qianshuyuank/MLKPAI-FMin01/02_hardware/03_开发板等长说明/MLKPAI-FMin01开发板等长说明.txt

HDMI 共8根GPIO/4对差分对，做pin pair全部等长；误差正负0.127MM；Len=38.4718MM

DVP    共20根GPIO/10对差分对，做pin pair全部等长；误差正负0.127MM；Len=20.1094MM

TF       共6根GPIO，做pin pair全部等长；误差正负0.127MM；Len=14.6431MM
