qianshuyuank/MLKPAI-FMin01/02_hardware/07_Pinlist/DVP接口引脚定义表.xlsx

DVP
信号名 |  | 管脚号
1 | VCC_3V3 | \
2 | VCC_3V3 | \
3 | B4_BE2N_40 | 40
4 | B4_BE2P_41 | 41
5 | B4_BE1P_37 | 37
6 | B4_BE1N_38 | 38
7 | GND | \
8 | \ | \
9 | \ | \
10 | GND | \
11 | \ | \
12 | \ | \
13 | B3_BE2N_33 | 33
14 | B3_BE2P_32 | 32
15 | GND | \
16 | \ | \
17 | \ | \
18 | B3_BE1N_28 | 28
19 | B3_BE1P_29 | 29
20 | GND | \
21 | B1_L2P_10 | 10
22 | B1_L2N_11 | 11
23 | B1_L3P_12 | 12
24 | B1_L3N_13 | 13
25 | GND | \
26 | B8_TE1N_87 | 87
27 | B8_TE1P_86 | 86
28 | B7_TE1P_70 | 70
29 | B7_TE1N_71 | 71
30 | GND | \
31 | \ | \
32 | \ | \
33 | B6_R2P_64 | 64
34 | B6_R2N_63 | 63
35 | \ | \
36 | \ | \
37 | B1_L1P_5 | 5
38 | B1_L1N_4 | 4
39 | \ | \
40 | \ | \
