qianshuyuank/MLKPAI-FMin01/02_hardware/07_Pinlist/LED、拨码开关、按键与蜂鸣器引脚定义表.xlsx

LED
信号名 | 管脚
B1_L4_14 | 14
B1_L2_3 | 3
B1_L1_2 | 2
B5_R2_51 | 51
B5_R3_52 | 52
B6_R1_57 | 57
B6_R2_59 | 59
B6_R3_62 | 62
按键
信号名 | 管脚
B3_B6_31 | 31
B3_B5_30 | 30
BUZZER
信号名 | 管脚
B3_B4_27 | 27
拨码开关
信号名 | 管脚
B5_R1_45 | 45
B3_B1_23 | 23
B2_L2_19 | 19
B2_L1_18 | 18
