qianshuyuank/MLKPAI-FMin01/02_hardware/07_Pinlist/FLASH管脚定义表.xlsx

信号名 | 引脚号 | FPGA管脚
AS_rCSO | /CS | 69
AS_DATA | DO | 80
AS_DCLK | CLK | 82
AS_ASDO | DI | 81
