qianshuyuank/MLKPAI-FMin01/02_hardware/07_Pinlist/HDMI引脚定义表.xlsx

HDMI
信号名 | 管脚号
B6_R1P_61 | 61
B6_R1N_60 | 60
B5_R2P_49 | 49
B5_R2N_50 | 50
B5_R1P_47 | 47
B5_R1N_48 | 48
B5_R3P_55 | 55
B5_R3N_54 | 54
