qianshuyuank/MLKPAI-FMin01/02_hardware/07_Pinlist/JTAG管脚定义表 .xlsx

信号名 | FPGA管脚
JTAG_TMS | 22
JTAG_TCK | 26
JTAG_TDO | 21
JTAG_TDI | 25
