qianshuyuank/MLKPAI-FMin01/02_hardware/07_Pinlist/TF卡槽、EEPROM与RTC引脚定义表.xlsx

TF
信号名 | 管脚号
B7_T5_74 | 74
B7_T6_75 | 75
B7_T7_76 | 76
B7_T2P_78 | 78
B7_TE2N_77 | 77
B7_T8_79 | 79
EEPROM/RTC
信号名 | 管脚号
B4_B2_39 | 39
B4_B3_42 | 42
