qianshuyuank/MLKPAI-FMin01/02_hardware/07_Pinlist/UART引脚信号定义表.xlsx

信号名 | 管脚
FPGA_UART_TXD | 17
FPGA_UART_RXD | 16
