qianshuyuank/MLKPAI-FMin01/01_start/02_peripheral_demo/01_run_led/SchematicImage.png

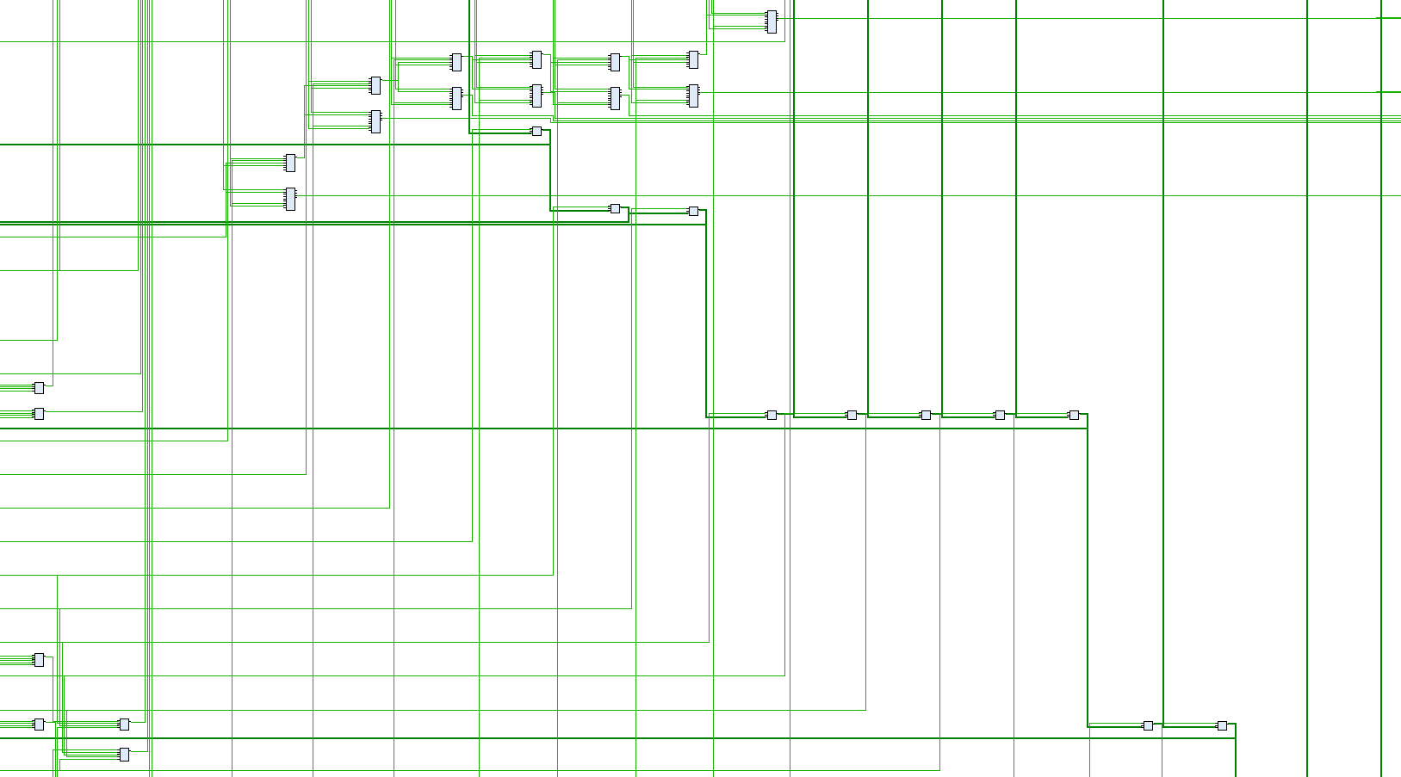
01_start/02_peripheral_demo/01_run_led/SchematicImage.png
