qianshuyuank/MLKPAI-FMin01/(list of files, cad)

Other CAD files:
02_hardware/06_DXF文件/MLKPAI-FMin01.dxf
