qianshuyuank/MLKPAI-FMin01/02_hardware/04_开发板尺寸/MLKPAI-FMin01开发板尺寸图.pdf

# ART FILM - 1

26

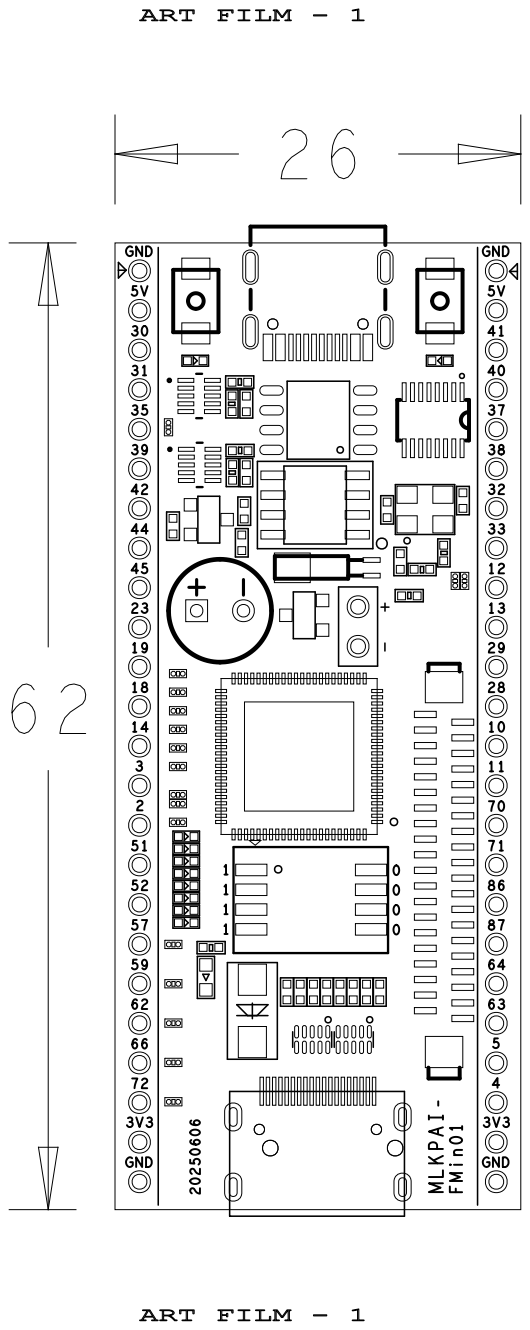
[picture p17: page 1]
ART FILM - 1; GND; MLKPAI-; FMin01

# ART FILM - 2

26

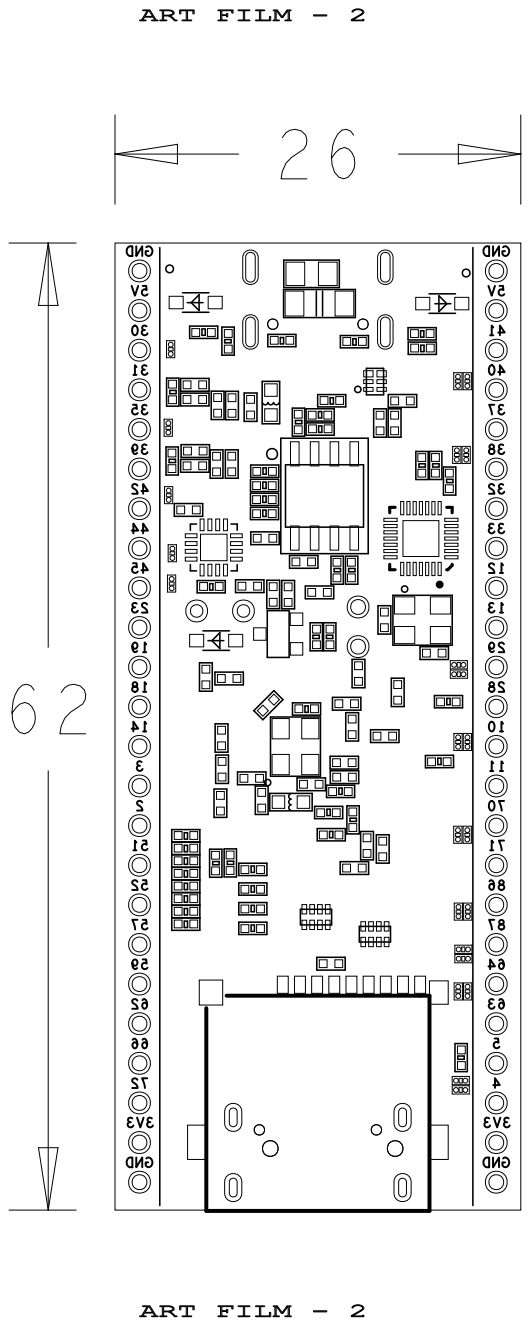
[picture p18: page 2]
ART FILM - 2; GND
