qianshuyuank/MLKPAI-FMin01/02_hardware/02_原理图/MLKPAI-FMin01原理图.pdf

2

## P03_BANK IO

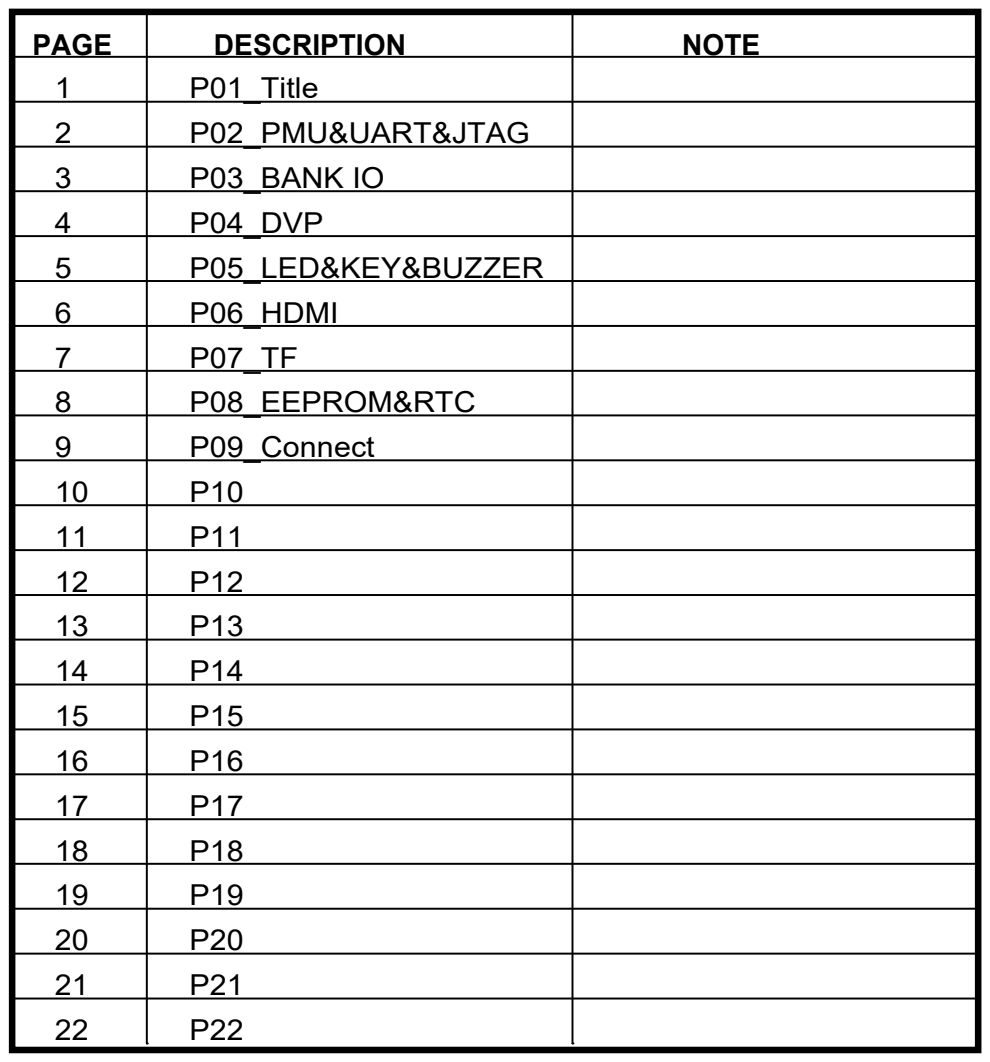
[picture p19: page 1]

米联客
www.uisrc.com <Doc>

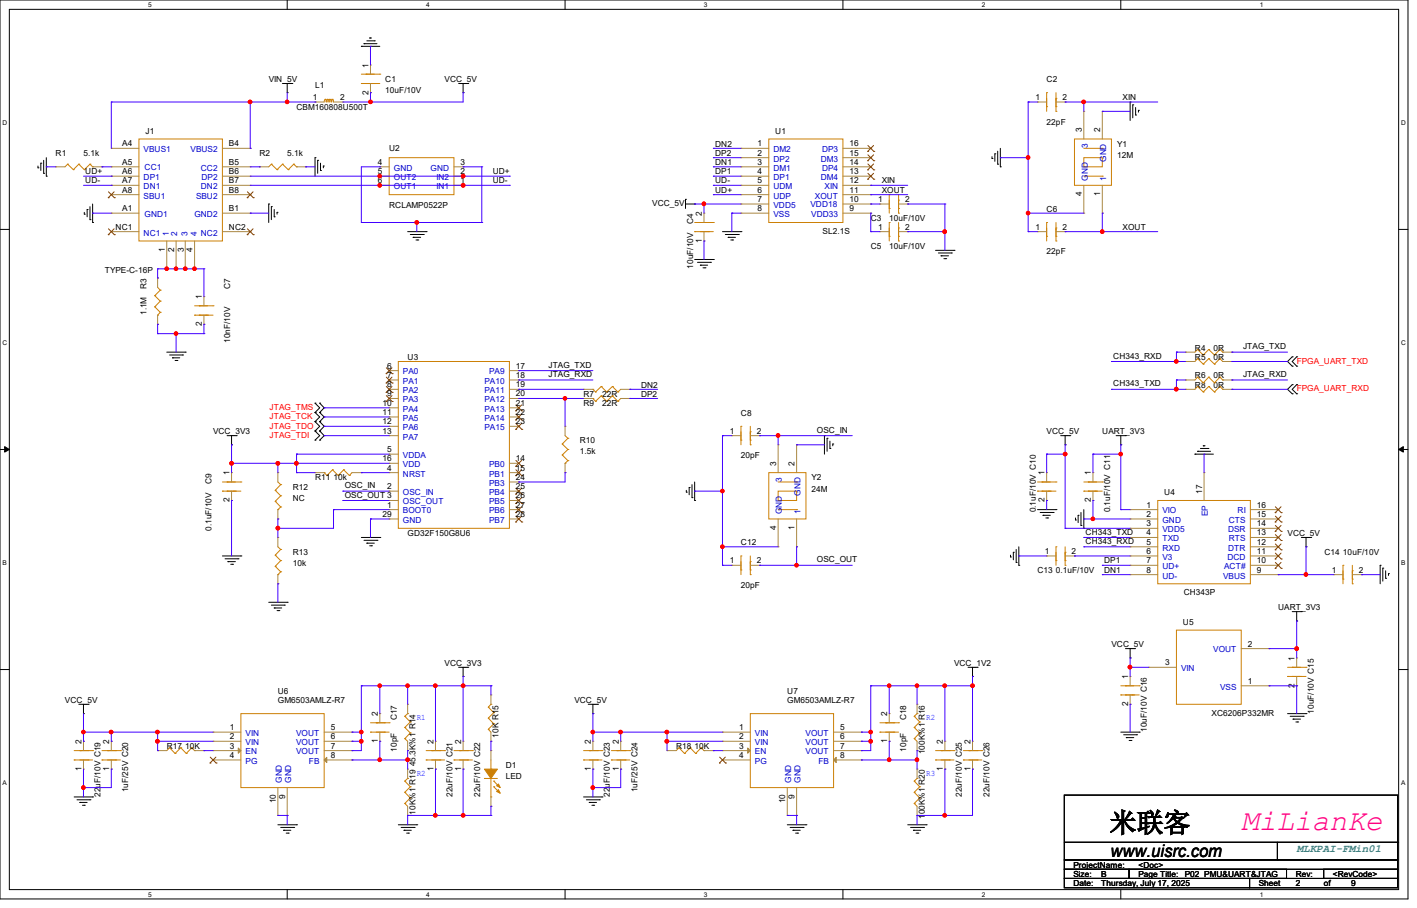
[picture p20: page 2]

米联客
www.uisrc.com <Doc>

D

# BANK IO

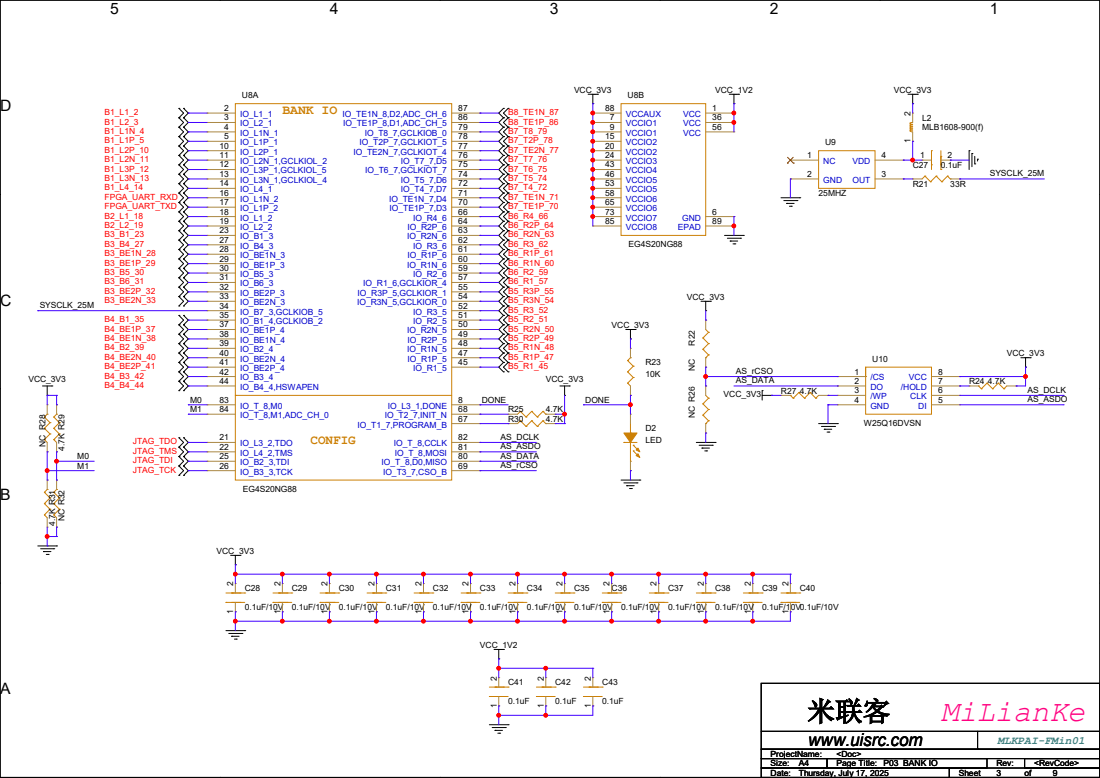
[picture p21: page 3]

米联客
www.uisrc.com <Doc>

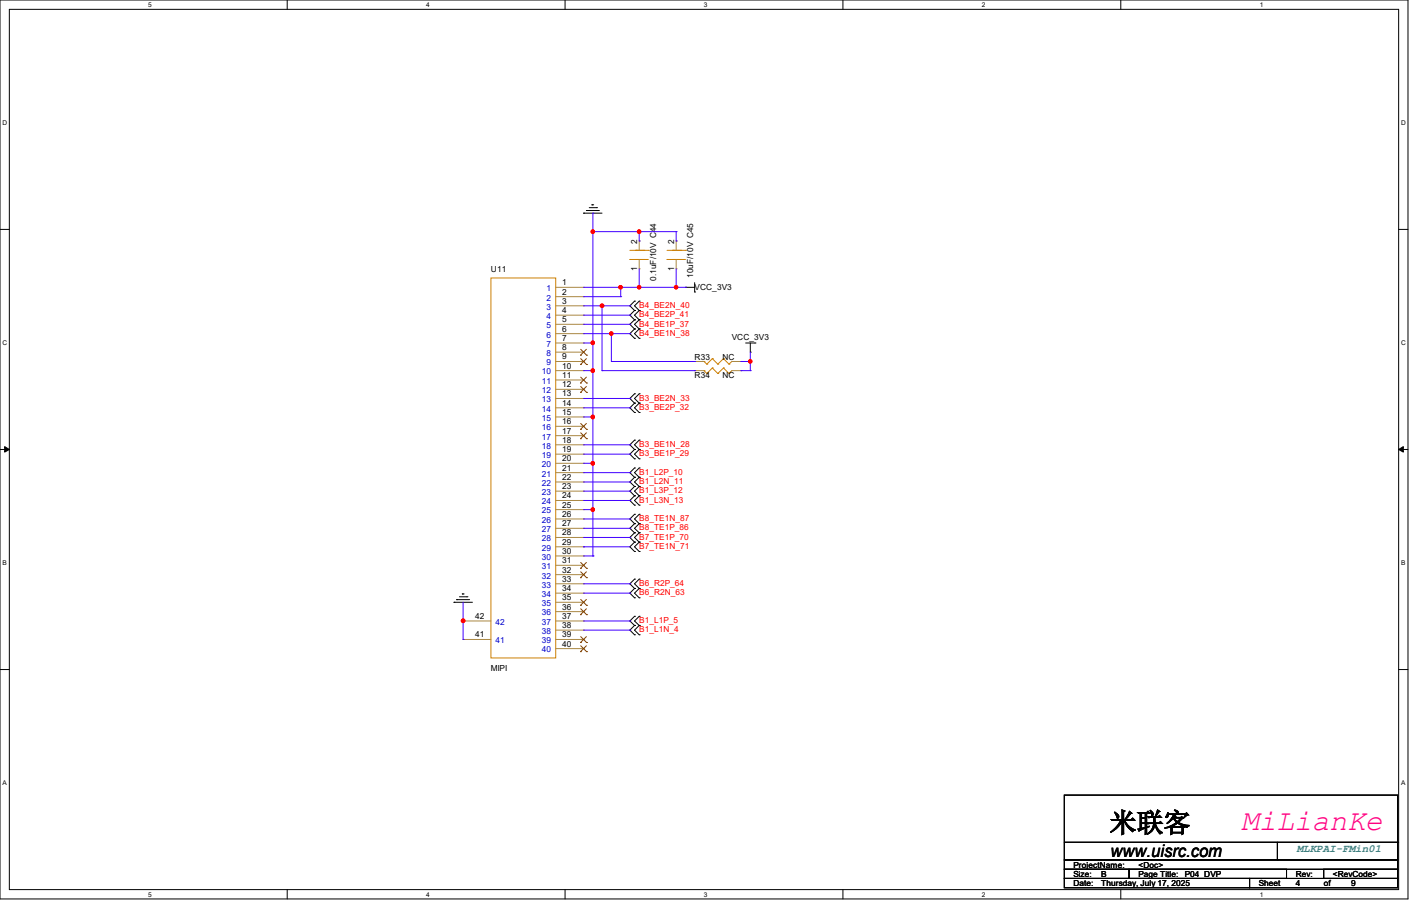
[picture p22: page 4]
MLKPA; FMi; e: Size:; Title:; uly; MIPI

v: 米联客 www.uisrc.com <Doc>

B

C

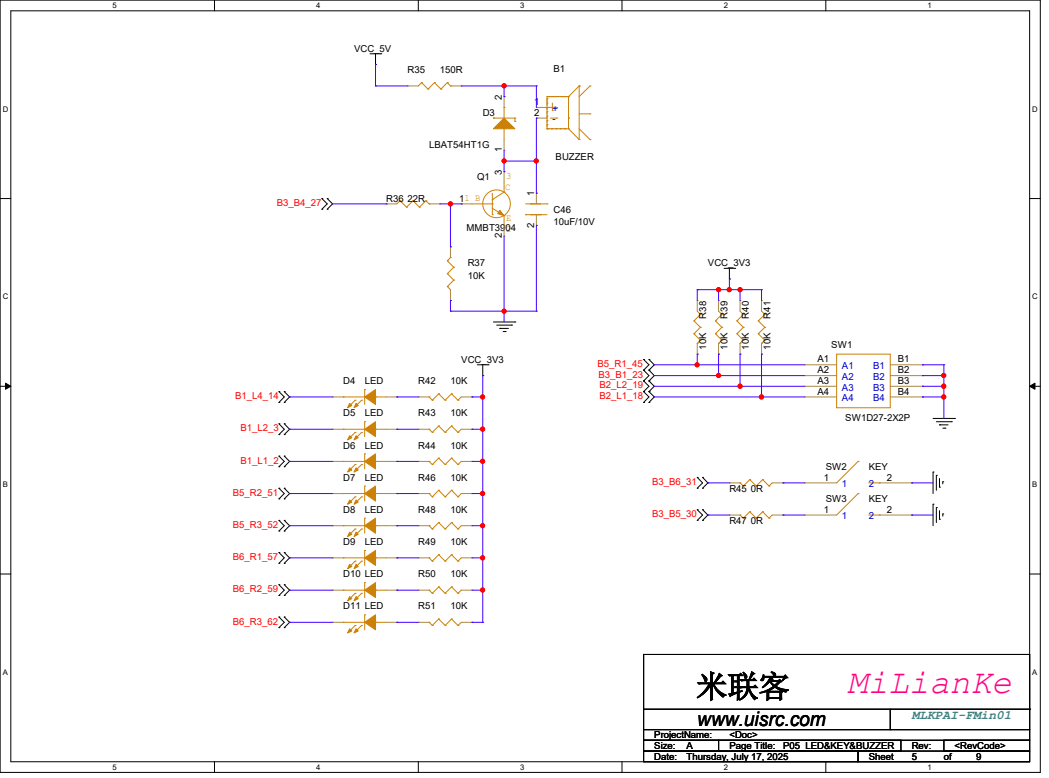
[picture p23: page 5]

米联客
www.uisrc.com <Doc>

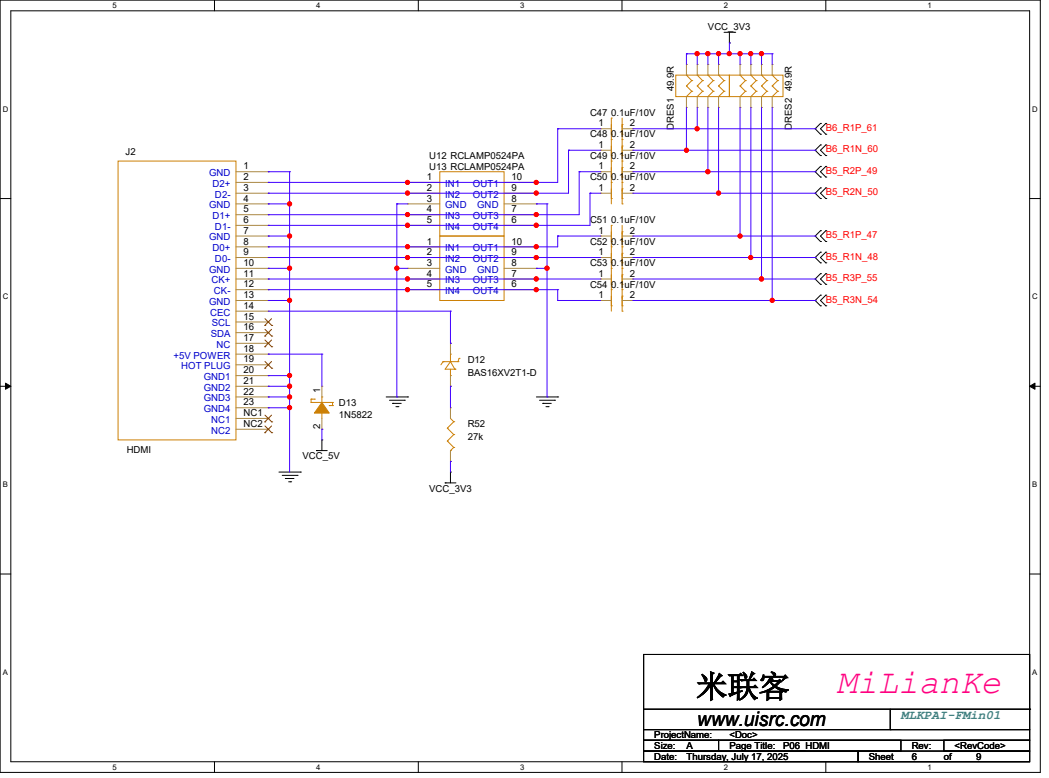
[picture p24: page 6]

米联客
www.uisrc.com <Doc>

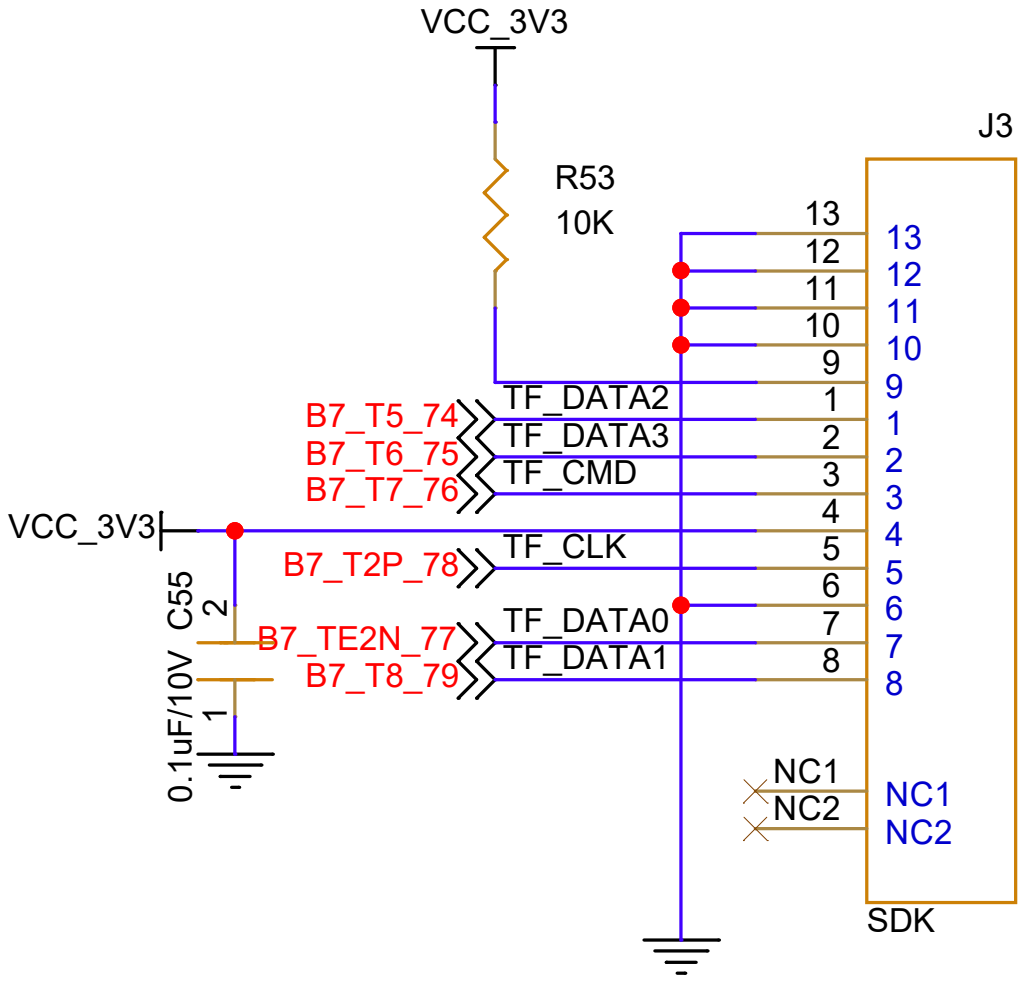
[picture p25: page 7]
MiLianKe; MLKPAI-FMin01; VCC_3V3; <RevCode>; Date: Thursday, July 17, 2025; Sheet; Thursday, July 17, 2025; SDK; TF_DATA2 TF_DATA3 TF_CMD; TF_CLK; TF_DATA0 TF_DATA1

米联客
www.uisrc.com <Doc>

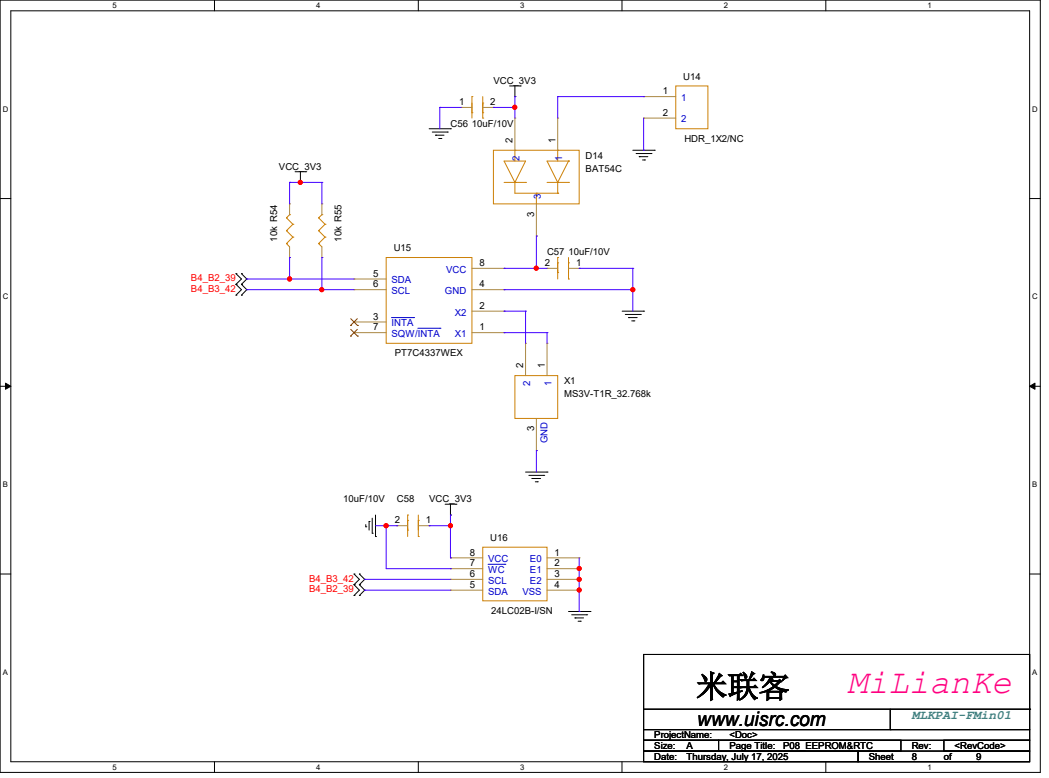
[picture p26: page 8]

米联客
www.uisrc.com <Doc>

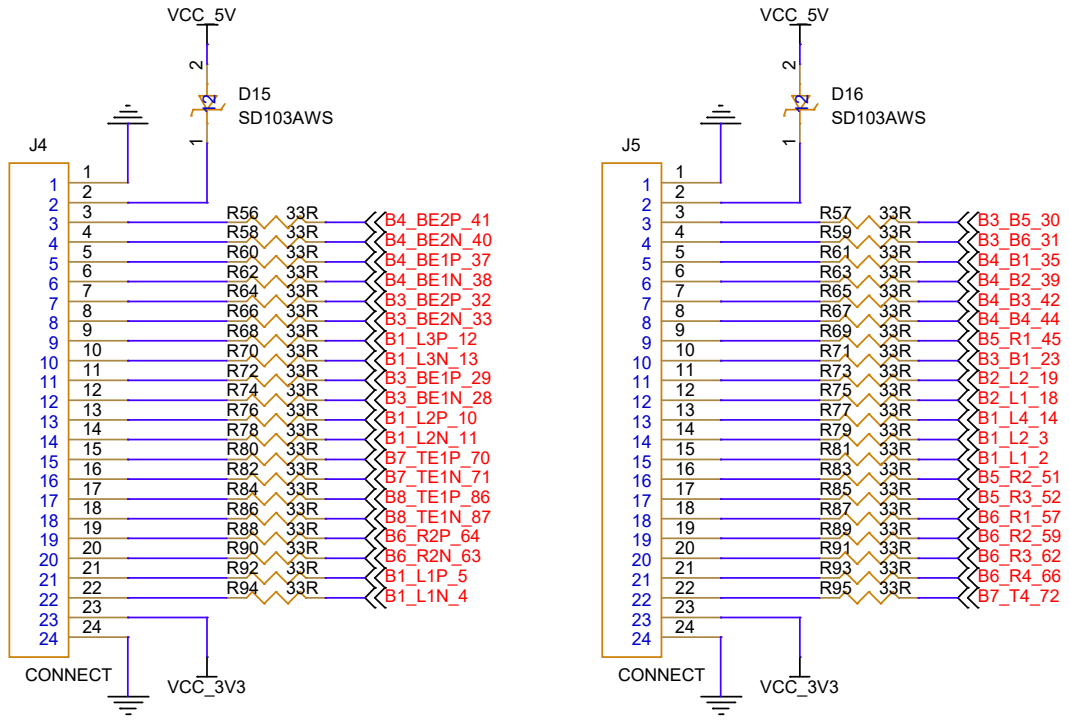
[picture p27: page 9]

米联客
www.uisrc.com <Doc>
