qianshuyuank/MLKPAI-FMin01/01_start/02_peripheral_demo/07_sdram_fdma/sdram_fdma_gc0308/uisrc/03_ip/uiSensorRGB565/uiSensorRGB565.v

`timescale 1ns / 1ps

/*******************************MILIANKE*******************************
*Company : MiLianKe Electronic Technology Co., Ltd.
*WebSite:https://www.milianke.com
*TechWeb:https://www.uisrc.com
*tmall-shop:https://milianke.tmall.com
*jd-shop:https://milianke.jd.com
*taobao-shop: https://milianke.taobao.com
*Create Date: 2021/04/25
*Module Name:
*File Name:
*Description: 
*The reference demo provided by Milianke is only used for learning. 
*We cannot ensure that the demo itself is free of bugs, so users 
*should be responsible for the technical problems and consequences
*caused by the use of their own products.
*Copyright: Copyright (c) MiLianKe
*All rights reserved.
*Revision: 1.0
*Signal description
*1) _i input
*2) _o output
*3) _n activ low
*4) _dg debug signal 
*5) _r delay or register
*6) _s state mechine
*********************************************************************/

module uiSensorRGB565(
    input rstn_i,
	input cmos_clk_i,//cmos senseor clock.
	input cmos_pclk_i,//input pixel clock.
	input cmos_href_i,//input pixel hs signal.
	input cmos_vsync_i,//input pixel vs signal.
	input [7:0]cmos_data_i,//data.
	output cmos_xclk_o,//output clock to cmos sensor.
    output [15:0] rgb565_o,
    //output [23:0] rgb_o,
    output de_o,
    output vs_o,
    output hs_o
    );
    
assign cmos_xclk_o = cmos_clk_i; 
     
reg cmos_href_r1 = 1'b0,cmos_href_r2 = 1'b0,cmos_href_r3 = 1'b0;
reg cmos_vsync_r1 = 1'b0,cmos_vsync_r2 = 1'b0;
reg [7:0]cmos_data_r1 = 8'b0;
reg [7:0]cmos_data_r2 = 8'b0;    

(* ASYNC_REG = "TRUE" *) reg rstn1,rstn2;

always@(posedge cmos_pclk_i)begin
    rstn1 <= rstn_i;
    rstn2 <= rstn1;
end



always@(posedge cmos_pclk_i)begin
       cmos_href_r1  <= cmos_href_i;
       cmos_href_r2  <= cmos_href_r1;
       cmos_href_r3  <= cmos_href_r2;       
       cmos_data_r1  <= cmos_data_i;
       cmos_data_r2  <= cmos_data_r1;
       cmos_vsync_r1 <= ~cmos_vsync_i;      
       cmos_vsync_r2 <= cmos_vsync_r1;       
end    

parameter FRAM_FREE_CNT = 5;
reg [7:0]vs_cnt;
wire vs_p = !cmos_vsync_r2&&cmos_vsync_r1;
always@(posedge cmos_pclk_i)begin
    if(!rstn2)begin
        vs_cnt <= 8'd0;
    end 
    else if(vs_p)begin
        if(vs_cnt < FRAM_FREE_CNT)
            vs_cnt <= vs_cnt + 1'b1;
         else
            vs_cnt <= vs_cnt;
    end
end    

wire out_en = (vs_cnt == FRAM_FREE_CNT);
//output data 8bit changed into 16bit in rgb565.

reg href_cnt   = 1'b0;
reg data_en  = 1'b0;
reg [15:0]rgb2 = 32'd0;
always@(posedge cmos_pclk_i)begin
	if(vs_p||(~out_en))begin
	   href_cnt  <= 1'd0;
	   data_en   <= 1'b0;
	   rgb2      <= 16'd0;
	end	
	else begin
	   href_cnt  <= cmos_href_r2 ?  href_cnt + 1'b1 : 1'b0 ;
       data_en   <= (href_cnt==1'd1);
       if(cmos_href_r2) begin
            rgb2 <= {rgb2[7:0],cmos_data_r2};
       end    
	end	
end

//assign  rgb_o  = {rgb2[15:11],3'd0,rgb2[10:5],2'd0,rgb2[4:0],3'd0};

assign  rgb565_o = rgb2;

assign	de_o   =  out_en && data_en ;
assign	vs_o   =  out_en && cmos_vsync_r2 ;
assign	hs_o   =  out_en && cmos_href_r3 ;

endmodule
