qianshuyuank/MLKPAI-FMin01/01_start/02_peripheral_demo/06_sdram_test/fdma_sdram_test_sim/uisrc/03_ip/enc_file/sdr_wrrd.enc.v

`timescale 1ns / 1ps
//////////////////////////////////////////////////////////////////////////////////
// Company: anlgoic
// Author: 	xg 
// description: sdram write and read operate
//////////////////////////////////////////////////////////////////////////////////

`define SIMULATION

`define   DATA_WIDTH                        32
`define   ADDR_WIDTH                        21
`define   DM_WIDTH                          4
`define   ROW_WIDTH                        11
`define   BA_WIDTH                        2


`pragma protect begin_protected
`pragma protect version = 1
`pragma protect encrypt_agent = "Anlogic"
`pragma protect encrypt_agent_info = "Anlogic Encryption Tool anlogic_2019"
`pragma protect key_keyowner = "Anlogic", key_keyname = "anlogic-rsa-002"
`pragma protect key_method = "rsa"
`pragma protect encoding = (enctype = "BASE64", line_length = 64, bytes = 128)
`pragma protect key_block
RgFY1umSQebEhVRlLICyCHR/BCei9LHm/W6LnUu1T8lRgg8BgI+oo3c2baf3WCpJ
D4iw+/O3fQ6Fssh+DDEueDwGhbfQhTfyYWhT01diidwOapa0s/sMrWUQpT+k38L4
cE4bSYH85ICQw79BEK5zGqbT6w4PAlkND5xI7jpM8sE=
`pragma protect key_keyowner = "Cadence Design Systems.", key_keyname = "CDS_RSA_KEY_VER_1"
`pragma protect key_method = "rsa"
`pragma protect encoding = (enctype = "BASE64", line_length = 64, bytes = 256)
`pragma protect key_block
pLr83iL9f9dsIwdB715lj1U6/9t3u6eyky2t/SgJ3OT+S/X2WnxNG4is6F6p311p
Q4E+/WE7bRXFYdLPjCs3PqAPVQX6bCz7TK7LSLyKg71qQUhO+CcNdZd4Pupk10+2
RxY1BYihSUdSh5bbGZxA8dM2P02Lzrcw95lwC1ahbH4z5YbQ/+8b6RenHrohRDrb
37lYDIEMY3P0VFY+l6n8VoKBioylTYLIFqYYgXp5nJUUo+ckR5AxxW2HZlZDzJO4
ODT7aux8sMBM3F9l10pf2J00hbxq77JuQgEtCZkln3ZEdFIJi6cG4l/LtC08MS9f
Rs8Ces7e71SXJnryFpgT8A==
`pragma protect key_keyowner = "Mentor Graphics Corporation", key_keyname = "MGC-VERIF-SIM-RSA-2"
`pragma protect key_method = "rsa"
`pragma protect encoding = (enctype = "BASE64", line_length = 64, bytes = 256)
`pragma protect key_block
ixnryfv7VOLxizRU1kT48AePHv4WtJEoPunEzG/lvdeERuHs81akGNNcuPtjU7K3
8VHtWNaWPrOquNbjwROMdjqqw5YSzcjlkTy3ESR4ifAQH2J6dh/skdTZRpdbsTpS
RztlSKZvmKB+SejTaR/401dxDav4JJ+I/a23oaP404TPGBgbYSQCUMLa7FPEZzQa
z5lkK9pZRD5N/no4mYJ0mzNM2UytBrnzIckFGlZ4ta4NkFletuQr/OzkYYYMFWfm
XtIpIchUiKnI7vL3ddxpQHHeNO0PMAtZv199g0e18BUKpPVz0vwtMeg2KQ71ZhJF
w+syjz5b52MvLTcosL3zFw==
`pragma protect key_keyowner = "Mentor Graphics Corporation", key_keyname = "MGC-VERIF-SIM-RSA-1"
`pragma protect key_method = "rsa"
`pragma protect encoding = (enctype = "BASE64", line_length = 64, bytes = 128)
`pragma protect key_block
d+YF/0abRVILUxeumOT/EZ/LLCwJnuWl0WAgjaoLQJCmF4+6gf12Hnl5D2lzXK9E
JVY0K6nUOiFs+xdrYRYMG6CcUiq4mWcPD3mn+YPYzgZ7jrKXllVoxUgmzgMVuEqX
vFqsFmU63NfCz77LGj+6rxNWbU+EgHsSS5NuSLGOSoo=
`pragma protect key_keyowner = "Mentor Graphics Corporation", key_keyname = "MGC-VERIF-SIM-RSA-2"
`pragma protect key_method = "rsa"
`pragma protect encoding = (enctype = "BASE64", line_length = 64, bytes = 256)
`pragma protect key_block
GcI06p4li2Sgd5cVcVnSr07etPopqvtEBYWA6oQjUqW00vlKCotH1LYV2k/G+LlK
6/3ohJbZNHMd+TqilINdOfNmXuoV4AVSsF19hRK/jVSn9JaYcd+EjAH/QX5p0Faf
asX3tgDYxpZxvq6Un/TfGnAM1sQgDhkfsHoQCUVL/BAhrCLlUzvVtr+j34CADCTW
ZsT/GE/OdJrOPYZZxCdNF0HPXEdvAE7QgqbtsbMaHS5USAzGs8kA+b5fpzj6jwV7
FSy1fNgAuKxAAWitXMRzEJNAT5AB4r/jjRZYfPkzv7G8SRLTvoSSH123duSSOxQi
rLxSgadznwhm81URAMbuFQ==
`pragma protect key_keyowner = "Synopsys", key_keyname = "SNPS-VCS-RSA-2"
`pragma protect key_method = "rsa"
`pragma protect encoding = (enctype = "BASE64", line_length = 64, bytes = 128)
`pragma protect key_block
VTr3bPgsTFcEbeRBViICHH6hgSAkx64gj5O2m+qPTFcBiP0L0yfUT4K19RYE2eKD
kOkmwwstKmojQl39vkKknH4KfFRz7uSbgCGHk63iCpsiHSOfiZJ5magjG15sZvvn
ZRaT970kz7dZ6oIRXC0Zhu6Ne0g26uBEn8nUPpIet2k=
`pragma protect data_method = "AES128-CBC"
`pragma protect encoding = (enctype = "BASE64", line_length = 64, bytes = 8544)
`pragma protect data_block
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
`pragma protect end_protected
