qianshuyuank/MLKPAI-FMin01/01_start/02_peripheral_demo/07_sdram_fdma/sdram_fdma_gc0308/uisrc/03_ip/ui_median/fifo_generator_0_sim.v

// Verilog netlist created by TD v5.0.43066
// Tue Apr 26 23:17:30 2022

`timescale 1ns / 1ps
module fifo_generator_0  // fifo_generator_0.v(14)
  (
  clk,
  di,
  re,
  rst,
  we,
  do,
  empty_flag,
  full_flag,
  rdusedw,
  wrusedw
  );

  input clk;  // fifo_generator_0.v(24)
  input [7:0] di;  // fifo_generator_0.v(23)
  input re;  // fifo_generator_0.v(25)
  input rst;  // fifo_generator_0.v(22)
  input we;  // fifo_generator_0.v(24)
  output [7:0] do;  // fifo_generator_0.v(27)
  output empty_flag;  // fifo_generator_0.v(28)
  output full_flag;  // fifo_generator_0.v(29)
  output [10:0] rdusedw;  // fifo_generator_0.v(30)
  output [10:0] wrusedw;  // fifo_generator_0.v(31)

  wire  \addr_inc_mux/B0_1 ;
  wire  \addr_inc_mux/B0_2 ;
  wire  \addr_inc_mux/B1_0 ;
  wire  \addr_inc_mux/B1_1 ;
  wire  \empty_r_mux/B0_0 ;
  wire  \empty_r_mux/B1_0 ;
  wire  \state_mux_b0/B0_0 ;
  wire  \state_mux_b0/B0_1 ;
  wire  \state_mux_b0/B0_2 ;
  wire  \state_mux_b0/B1_0 ;
  wire  \state_mux_b0/B1_1 ;
  wire  \state_mux_b1/B0_0 ;
  wire  \state_mux_b1/B0_1 ;
  wire  \state_mux_b1/B0_2 ;
  wire  \state_mux_b1/B1_0 ;
  wire  \state_mux_b1/B1_1 ;
  wire  \state_mux_b2/B0_0 ;
  wire  \state_mux_b2/B0_1 ;
  wire  \state_mux_b2/B0_2 ;
  wire  \state_mux_b2/B1_0 ;
  wire  \state_mux_b2/B1_1 ;
  wire addr_inc;
  wire and_addr_inc_empty_e_o;
  wire and_and__al_n1_q0_al_o;
  wire and_and__al_n1_q0_al_o_al_n75;
  wire and_and__al_n1_q0_ne_o;
  wire and_and_and__al_n1_q_o;
  wire and_and_and__al_n1_q_o_al_n31;
  wire and_and_and__al_n1_q_o_al_n76;
  wire and_and_and_and__al__o;
  wire and_and_and_and__al__o_al_n32;
  wire and_and_and_and__al__o_al_n77;
  wire and_and_and_and_and__o;
  wire and_and_and_and_and__o_al_n0;
  wire and_and_and_and_and__o_al_n1;
  wire and_and_and_and_and__o_al_n2;
  wire and_and_and_and_and__o_al_n3;
  wire and_and_and_and_and__o_al_n33;
  wire and_and_and_and_and__o_al_n34;
  wire and_and_and_and_and__o_al_n35;
  wire and_and_and_and_and__o_al_n36;
  wire and_and_and_and_and__o_al_n37;
  wire and_and_and_and_and__o_al_n38;
  wire and_and_and_and_and__o_al_n4;
  wire and_and_and_and_and__o_al_n78;
  wire and_and_and_and_and__o_al_n79;
  wire and_and_and_and_and__o_al_n80;
  wire and_and_and_and_and__o_al_n81;
  wire and_and_and_and_and__o_al_n82;
  wire and_and_and_and_and__o_al_n83;
  wire and_empty_equal_test_o;
  wire and_empty_equal_test_o_al_n6;
  wire and_or_q11_al_n30_q1_o;
  wire and_or_q11_al_n74_q1_o;
  wire and_or_q11_q10_o_and_o;
  wire and_q1_al_n20_and__a_o;
  wire and_q1_al_n64_and__a_o;
  wire and_q1_and__al_n1_q0_o;
  wire and_q2_al_n21_and_an_o;
  wire and_q2_al_n65_and_an_o;
  wire and_q2_and_and__al_n_o;
  wire and_q3_al_n22_and_an_o;
  wire and_q3_al_n66_and_an_o;
  wire and_q3_and_and_and___o;
  wire and_q4_al_n23_and_an_o;
  wire and_q4_al_n67_and_an_o;
  wire and_q4_and_and_and_a_o;
  wire and_q5_al_n24_and_an_o;
  wire and_q5_al_n68_and_an_o;
  wire and_q5_and_and_and_a_o;
  wire and_q6_al_n25_and_an_o;
  wire and_q6_al_n69_and_an_o;
  wire and_q6_and_and_and_a_o;
  wire and_q7_al_n26_and_an_o;
  wire and_q7_al_n70_and_an_o;
  wire and_q7_and_and_and_a_o;
  wire and_q8_al_n27_and_an_o;
  wire and_q8_al_n71_and_an_o;
  wire and_q8_and_and_and_a_o;
  wire and_q9_al_n28_and_an_o;
  wire and_q9_al_n72_and_an_o;
  wire and_q9_and_and_and_a_o;
  wire and_re_or_empty_equa_o;
  wire and_re_or_empty_equa_o_neg;
  wire and_s_state_mux_o0_a_o;
  wire and_s_state_mux_o0_a_o_al_n16;
  wire and_s_state_mux_o0_a_o_al_n17;
  wire and_s_state_mux_o0_a_o_al_n18;
  wire and_we_full_equal_o__o;
  wire curr_state0;
  wire curr_state1;
  wire curr_state2;
  wire data_mux_r1_1_o0;
  wire data_mux_r1_1_o1;
  wire data_mux_r1_1_o2;
  wire data_mux_r1_1_o3;
  wire data_mux_r1_1_o4;
  wire data_mux_r1_1_o5;
  wire data_mux_r1_1_o6;
  wire data_mux_r1_1_o7;
  wire data_mux_r1_2_o0;
  wire data_mux_r1_2_o1;
  wire data_mux_r1_2_o2;
  wire data_mux_r1_2_o3;
  wire data_mux_r1_2_o4;
  wire data_mux_r1_2_o5;
  wire data_mux_r1_2_o6;
  wire data_mux_r1_2_o7;
  wire data_mux_r1_3_o0;
  wire data_mux_r1_3_o1;
  wire data_mux_r1_3_o2;
  wire data_mux_r1_3_o3;
  wire data_mux_r1_3_o4;
  wire data_mux_r1_3_o5;
  wire data_mux_r1_3_o6;
  wire data_mux_r1_3_o7;
  wire data_mux_r1_4_o0;
  wire data_mux_r1_4_o1;
  wire data_mux_r1_4_o2;
  wire data_mux_r1_4_o3;
  wire data_mux_r1_4_o4;
  wire data_mux_r1_4_o5;
  wire data_mux_r1_4_o6;
  wire data_mux_r1_4_o7;
  wire data_mux_r1_5_o0;
  wire data_mux_r1_5_o1;
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
  wire wrptr_g1;
  wire wrptr_g10;
  wire wrptr_g2;
  wire wrptr_g3;
  wire wrptr_g4;
  wire wrptr_g5;
  wire wrptr_g6;
  wire wrptr_g7;
  wire wrptr_g8;
  wire wrptr_g9;
  wire wrptr_g_bin_d10;
  wire wrptr_g_bin_d11;
  wire wrptr_g_bin_d12;
  wire wrptr_g_bin_d13;
  wire wrptr_g_bin_d14;
  wire wrptr_g_bin_d15;
  wire wrptr_g_bin_d16;
  wire wrptr_g_bin_d17;
  wire wrptr_g_bin_d18;
  wire wrptr_g_bin_d19;
  wire \wrusedw_sub/c0 ;
  wire \wrusedw_sub/c1 ;
  wire \wrusedw_sub/c10 ;
  wire \wrusedw_sub/c2 ;
  wire \wrusedw_sub/c3 ;
  wire \wrusedw_sub/c4 ;
  wire \wrusedw_sub/c5 ;
  wire \wrusedw_sub/c6 ;
  wire \wrusedw_sub/c7 ;
  wire \wrusedw_sub/c8 ;
  wire \wrusedw_sub/c9 ;
  wire xor_q10_al_n29_and_q_o;
  wire xor_q10_al_n73_and_q_o;
  wire xor_q10_and_q9_and_a_o;
  wire xor_q11_al_n30_and_o_o;
  wire xor_q11_al_n74_and_o_o;
  wire xor_q11_and_or_q11_q_o;
  wire xor_q1_al_n20_and_q0_o;
  wire xor_q1_al_n64_and_q0_o;
  wire xor_q1_and_q0__al_n1_o;
  wire xor_q2_al_n21_and_q1_o;
  wire xor_q2_al_n65_and_q1_o;
  wire xor_q2_and_q1_and__a_o;
  wire xor_q3_al_n22_and_q2_o;
  wire xor_q3_al_n66_and_q2_o;
  wire xor_q3_and_q2_and_an_o;
  wire xor_q4_al_n23_and_q3_o;
  wire xor_q4_al_n67_and_q3_o;
  wire xor_q4_and_q3_and_an_o;
  wire xor_q5_al_n24_and_q4_o;
  wire xor_q5_al_n68_and_q4_o;
  wire xor_q5_and_q4_and_an_o;
  wire xor_q6_al_n25_and_q5_o;
  wire xor_q6_al_n69_and_q5_o;
  wire xor_q6_and_q5_and_an_o;
  wire xor_q7_al_n26_and_q6_o;
  wire xor_q7_al_n70_and_q6_o;
  wire xor_q7_and_q6_and_an_o;
  wire xor_q8_al_n27_and_q7_o;
  wire xor_q8_al_n71_and_q7_o;
  wire xor_q8_and_q7_and_an_o;
  wire xor_q9_al_n28_and_q8_o;
  wire xor_q9_al_n72_and_q8_o;
  wire xor_q9_and_q8_and_an_o;
  wire xor_rdptr_g10_rdptr__o_al_n127;
  wire xor_rdptr_g_test10_r_o;
  wire xor_sync_delayed_wrp_o;
  wire xor_sync_rdptr_g10_s_o;
  wire xor_wrptr_g10_wrptr__o;
  wire xor_xor_rdptr_g10_rd_o;
  wire xor_xor_sync_delayed_o;
  wire xor_xor_sync_rdptr_g_o;
  wire xor_xor_wrptr_g10_wr_o;
  wire xor_xor_xor_rdptr_g1_o;
  wire xor_xor_xor_sync_del_o;
  wire xor_xor_xor_sync_rdp_o;
  wire xor_xor_xor_wrptr_g1_o;
  wire xor_xor_xor_xor_rdpt_o;
  wire xor_xor_xor_xor_sync_o;
  wire xor_xor_xor_xor_sync_o_al_n120;
  wire xor_xor_xor_xor_wrpt_o;
  wire xor_xor_xor_xor_xor__o;
  wire xor_xor_xor_xor_xor__o_al_n108;
  wire xor_xor_xor_xor_xor__o_al_n109;
  wire xor_xor_xor_xor_xor__o_al_n110;
  wire xor_xor_xor_xor_xor__o_al_n111;
  wire xor_xor_xor_xor_xor__o_al_n112;
  wire xor_xor_xor_xor_xor__o_al_n114;
  wire xor_xor_xor_xor_xor__o_al_n115;
  wire xor_xor_xor_xor_xor__o_al_n116;
  wire xor_xor_xor_xor_xor__o_al_n117;
  wire xor_xor_xor_xor_xor__o_al_n118;
  wire xor_xor_xor_xor_xor__o_al_n119;
  wire xor_xor_xor_xor_xor__o_al_n121;
  wire xor_xor_xor_xor_xor__o_al_n122;
  wire xor_xor_xor_xor_xor__o_al_n123;
  wire xor_xor_xor_xor_xor__o_al_n124;
  wire xor_xor_xor_xor_xor__o_al_n125;
  wire xor_xor_xor_xor_xor__o_al_n126;
  wire xor_xor_xor_xor_xor__o_al_n128;
  wire xor_xor_xor_xor_xor__o_al_n129;
  wire xor_xor_xor_xor_xor__o_al_n130;
  wire xor_xor_xor_xor_xor__o_al_n131;
  wire xor_xor_xor_xor_xor__o_al_n132;
  wire xor_xor_xor_xor_xor__o_al_n133;

  AL_MUX \addr_inc_mux/al_mux_b0_0_1  (
    .i0(and_empty_equal_test_o_al_n6),
    .i1(and_re_or_empty_equa_o),
    .sel(curr_state0),
    .o(\addr_inc_mux/B0_1 ));
  AL_MUX \addr_inc_mux/al_mux_b0_0_2  (
    .i0(and_re_or_empty_equa_o),
    .i1(1'b0),
    .sel(curr_state0),
    .o(\addr_inc_mux/B0_2 ));
  AL_MUX \addr_inc_mux/al_mux_b0_1_0  (
    .i0(empty_equal_test_o_neg),
    .i1(\addr_inc_mux/B0_1 ),
    .sel(curr_state1),
    .o(\addr_inc_mux/B1_0 ));
  AL_MUX \addr_inc_mux/al_mux_b0_1_1  (
    .i0(\addr_inc_mux/B0_2 ),
    .i1(1'b0),
    .sel(curr_state1),
    .o(\addr_inc_mux/B1_1 ));
  AL_MUX \addr_inc_mux/al_mux_b0_2_0  (
    .i0(\addr_inc_mux/B1_0 ),
    .i1(\addr_inc_mux/B1_1 ),
    .sel(curr_state2),
    .o(addr_inc));
  and and_addr_inc_empty_e (and_addr_inc_empty_e_o, addr_inc, empty_equal_test_o_neg);
  and and_and__al_n1_q0_al (and_and__al_n1_q0_al_o, q0_al_n19_neg, q1_al_n20_neg);
  and and_and__al_n1_q0_al_al_u31 (and_and__al_n1_q0_al_o_al_n75, q0_al_n63_neg, q1_al_n64_neg);
  and and_and__al_n1_q0_ne (and_and__al_n1_q0_ne_o, q0_neg, q1_neg);
  and and_and_and__al_n1_q (and_and_and__al_n1_q_o, and_and__al_n1_q0_ne_o, q2_neg);
  and and_and_and__al_n1_q_al_u19 (and_and_and__al_n1_q_o_al_n31, and_and__al_n1_q0_al_o, q2_al_n21_neg);
  and and_and_and__al_n1_q_al_u32 (and_and_and__al_n1_q_o_al_n76, and_and__al_n1_q0_al_o_al_n75, q2_al_n65_neg);
  and and_and_and_and__al_ (and_and_and_and__al__o, and_and_and__al_n1_q_o, q3_neg);
  and and_and_and_and__al__al_u20 (and_and_and_and__al__o_al_n32, and_and_and__al_n1_q_o_al_n31, q3_al_n22_neg);
  and and_and_and_and__al__al_u33 (and_and_and_and__al__o_al_n77, and_and_and__al_n1_q_o_al_n76, q3_al_n66_neg);
  and and_and_and_and_and_ (and_and_and_and_and__o, and_and_and_and__al__o, q4_neg);
  and and_and_and_and_and__al_u0 (and_and_and_and_and__o_al_n0, and_and_and_and_and__o, q5_neg);
  and and_and_and_and_and__al_u1 (and_and_and_and_and__o_al_n1, and_and_and_and_and__o_al_n0, q6_neg);
  and and_and_and_and_and__al_u2 (and_and_and_and_and__o_al_n2, and_and_and_and_and__o_al_n1, q7_neg);
  and and_and_and_and_and__al_u21 (and_and_and_and_and__o_al_n33, and_and_and_and__al__o_al_n32, q4_al_n23_neg);
  and and_and_and_and_and__al_u22 (and_and_and_and_and__o_al_n34, and_and_and_and_and__o_al_n33, q5_al_n24_neg);
  and and_and_and_and_and__al_u23 (and_and_and_and_and__o_al_n35, and_and_and_and_and__o_al_n34, q6_al_n25_neg);
  and and_and_and_and_and__al_u24 (and_and_and_and_and__o_al_n36, and_and_and_and_and__o_al_n35, q7_al_n26_neg);
  and and_and_and_and_and__al_u25 (and_and_and_and_and__o_al_n37, and_and_and_and_and__o_al_n36, q8_al_n27_neg);
  and and_and_and_and_and__al_u26 (and_and_and_and_and__o_al_n38, and_and_and_and_and__o_al_n37, q9_al_n28_neg);
  and and_and_and_and_and__al_u3 (and_and_and_and_and__o_al_n3, and_and_and_and_and__o_al_n2, q8_neg);
  and and_and_and_and_and__al_u34 (and_and_and_and_and__o_al_n78, and_and_and_and__al__o_al_n77, q4_al_n67_neg);
  and and_and_and_and_and__al_u35 (and_and_and_and_and__o_al_n79, and_and_and_and_and__o_al_n78, q5_al_n68_neg);
  and and_and_and_and_and__al_u36 (and_and_and_and_and__o_al_n80, and_and_and_and_and__o_al_n79, q6_al_n69_neg);
  and and_and_and_and_and__al_u37 (and_and_and_and_and__o_al_n81, and_and_and_and_and__o_al_n80, q7_al_n70_neg);
  and and_and_and_and_and__al_u38 (and_and_and_and_and__o_al_n82, and_and_and_and_and__o_al_n81, q8_al_n71_neg);
  and and_and_and_and_and__al_u39 (and_and_and_and_and__o_al_n83, and_and_and_and_and__o_al_n82, q9_al_n72_neg);
  and and_and_and_and_and__al_u4 (and_and_and_and_and__o_al_n4, and_and_and_and_and__o_al_n3, q9_neg);
  and and_empty_equal_test (and_empty_equal_test_o, empty_equal_test_o_neg_neg, and_re_or_empty_equa_o);
  and and_empty_equal_test_al_u6 (and_empty_equal_test_o_al_n6, empty_equal_test_o_neg, and_re_or_empty_equa_o_neg);
  and and_or_q11_al_n30_q1 (and_or_q11_al_n30_q1_o, or_q11_al_n30_q10_al_o, and_and_and_and_and__o_al_n38);
  and and_or_q11_al_n74_q1 (and_or_q11_al_n74_q1_o, or_q11_al_n74_q10_al_o, and_and_and_and_and__o_al_n83);
  and and_or_q11_q10_o_and (and_or_q11_q10_o_and_o, or_q11_q10_o, and_and_and_and_and__o_al_n4);
  and and_q1_al_n20_and__a (and_q1_al_n20_and__a_o, q1_al_n20, q0_al_n19_neg);
  and and_q1_al_n64_and__a (and_q1_al_n64_and__a_o, q1_al_n64, q0_al_n63_neg);
  and and_q1_and__al_n1_q0 (and_q1_and__al_n1_q0_o, q1, q0_neg);
  and and_q2_al_n21_and_an (and_q2_al_n21_and_an_o, q2_al_n21, and_and__al_n1_q0_al_o);
  and and_q2_al_n65_and_an (and_q2_al_n65_and_an_o, q2_al_n65, and_and__al_n1_q0_al_o_al_n75);
  and and_q2_and_and__al_n (and_q2_and_and__al_n_o, q2, and_and__al_n1_q0_ne_o);
  and and_q3_al_n22_and_an (and_q3_al_n22_and_an_o, q3_al_n22, and_and_and__al_n1_q_o_al_n31);
  and and_q3_al_n66_and_an (and_q3_al_n66_and_an_o, q3_al_n66, and_and_and__al_n1_q_o_al_n76);
  and and_q3_and_and_and__ (and_q3_and_and_and___o, q3, and_and_and__al_n1_q_o);
  and and_q4_al_n23_and_an (and_q4_al_n23_and_an_o, q4_al_n23, and_and_and_and__al__o_al_n32);
  and and_q4_al_n67_and_an (and_q4_al_n67_and_an_o, q4_al_n67, and_and_and_and__al__o_al_n77);
  and and_q4_and_and_and_a (and_q4_and_and_and_a_o, q4, and_and_and_and__al__o);
  and and_q5_al_n24_and_an (and_q5_al_n24_and_an_o, q5_al_n24, and_and_and_and_and__o_al_n33);
  and and_q5_al_n68_and_an (and_q5_al_n68_and_an_o, q5_al_n68, and_and_and_and_and__o_al_n78);
  and and_q5_and_and_and_a (and_q5_and_and_and_a_o, q5, and_and_and_and_and__o);
  and and_q6_al_n25_and_an (and_q6_al_n25_and_an_o, q6_al_n25, and_and_and_and_and__o_al_n34);
  and and_q6_al_n69_and_an (and_q6_al_n69_and_an_o, q6_al_n69, and_and_and_and_and__o_al_n79);
  and and_q6_and_and_and_a (and_q6_and_and_and_a_o, q6, and_and_and_and_and__o_al_n0);
  and and_q7_al_n26_and_an (and_q7_al_n26_and_an_o, q7_al_n26, and_and_and_and_and__o_al_n35);
  and and_q7_al_n70_and_an (and_q7_al_n70_and_an_o, q7_al_n70, and_and_and_and_and__o_al_n80);
  and and_q7_and_and_and_a (and_q7_and_and_and_a_o, q7, and_and_and_and_and__o_al_n1);
  and and_q8_al_n27_and_an (and_q8_al_n27_and_an_o, q8_al_n27, and_and_and_and_and__o_al_n36);
  and and_q8_al_n71_and_an (and_q8_al_n71_and_an_o, q8_al_n71, and_and_and_and_and__o_al_n81);
  and and_q8_and_and_and_a (and_q8_and_and_and_a_o, q8, and_and_and_and_and__o_al_n2);
  and and_q9_al_n28_and_an (and_q9_al_n28_and_an_o, q9_al_n28, and_and_and_and_and__o_al_n37);
  and and_q9_al_n72_and_an (and_q9_al_n72_and_an_o, q9_al_n72, and_and_and_and_and__o_al_n82);
  and and_q9_and_and_and_a (and_q9_and_and_and_a_o, q9, and_and_and_and_and__o_al_n3);
  and and_re_or_empty_equa (and_re_or_empty_equa_o, re, or_empty_equal_o_sho_o_neg);
  not and_re_or_empty_equa_o_inv (and_re_or_empty_equa_o_neg, and_re_or_empty_equa_o);
  and and_s_state_mux_o0_a (and_s_state_mux_o0_a_o, s_state_mux_o0_al_n13, and_re_or_empty_equa_o_neg);
  and and_s_state_mux_o0_a_al_u16 (and_s_state_mux_o0_a_o_al_n16, s_state_mux_o0_al_n13, and_re_or_empty_equa_o);
  and and_s_state_mux_o0_a_al_u17 (and_s_state_mux_o0_a_o_al_n17, s_state_mux_o0_al_n12, and_re_or_empty_equa_o);
  and and_s_state_mux_o0_a_al_u18 (and_s_state_mux_o0_a_o_al_n18, s_state_mux_o0_al_n11, empty_equal_test_o_neg);
  and and_we_full_equal_o_ (and_we_full_equal_o__o, we, full_equal_o_neg);
  EG_PHY_CONFIG #(
    .DONE_PERSISTN("ENABLE"),
    .INIT_PERSISTN("ENABLE"),
    .JTAG_PERSISTN("DISABLE"),
    .PROGRAMN_PERSISTN("DISABLE"))
    config_inst ();
  AL_MUX \data_mux_r1_1_b0/al_mux_b0_0_0  (
    .i0(r10),
    .i1(ram_q0),
    .sel(and_s_state_mux_o0_a_o),
    .o(data_mux_r1_1_o0));
  AL_MUX \data_mux_r1_1_b1/al_mux_b0_0_0  (
    .i0(r11),
    .i1(ram_q1),
    .sel(and_s_state_mux_o0_a_o),
    .o(data_mux_r1_1_o1));
  AL_MUX \data_mux_r1_1_b2/al_mux_b0_0_0  (
    .i0(r12),
    .i1(ram_q2),
    .sel(and_s_state_mux_o0_a_o),
    .o(data_mux_r1_1_o2));
  AL_MUX \data_mux_r1_1_b3/al_mux_b0_0_0  (
    .i0(r13),
    .i1(ram_q3),
    .sel(and_s_state_mux_o0_a_o),
    .o(data_mux_r1_1_o3));
  AL_MUX \data_mux_r1_1_b4/al_mux_b0_0_0  (
    .i0(r14),
    .i1(ram_q4),
    .sel(and_s_state_mux_o0_a_o),
    .o(data_mux_r1_1_o4));
  AL_MUX \data_mux_r1_1_b5/al_mux_b0_0_0  (
    .i0(r15),
    .i1(ram_q5),
    .sel(and_s_state_mux_o0_a_o),
    .o(data_mux_r1_1_o5));
  AL_MUX \data_mux_r1_1_b6/al_mux_b0_0_0  (
    .i0(r16),
    .i1(ram_q6),
    .sel(and_s_state_mux_o0_a_o),
    .o(data_mux_r1_1_o6));
  AL_MUX \data_mux_r1_1_b7/al_mux_b0_0_0  (
    .i0(r17),
    .i1(ram_q7),
    .sel(and_s_state_mux_o0_a_o),
    .o(data_mux_r1_1_o7));
  AL_MUX \data_mux_r1_2_b0/al_mux_b0_0_0  (
    .i0(data_mux_r1_1_o0),
    .i1(1'b0),
    .sel(and_s_state_mux_o0_a_o_al_n16),
    .o(data_mux_r1_2_o0));
  AL_MUX \data_mux_r1_2_b1/al_mux_b0_0_0  (
    .i0(data_mux_r1_1_o1),
    .i1(1'b0),
    .sel(and_s_state_mux_o0_a_o_al_n16),
    .o(data_mux_r1_2_o1));
  AL_MUX \data_mux_r1_2_b2/al_mux_b0_0_0  (
    .i0(data_mux_r1_1_o2),
    .i1(1'b0),
    .sel(and_s_state_mux_o0_a_o_al_n16),
    .o(data_mux_r1_2_o2));
  AL_MUX \data_mux_r1_2_b3/al_mux_b0_0_0  (
    .i0(data_mux_r1_1_o3),
    .i1(1'b0),
    .sel(and_s_state_mux_o0_a_o_al_n16),
    .o(data_mux_r1_2_o3));
  AL_MUX \data_mux_r1_2_b4/al_mux_b0_0_0  (
    .i0(data_mux_r1_1_o4),
    .i1(1'b0),
    .sel(and_s_state_mux_o0_a_o_al_n16),
    .o(data_mux_r1_2_o4));
  AL_MUX \data_mux_r1_2_b5/al_mux_b0_0_0  (
    .i0(data_mux_r1_1_o5),
    .i1(1'b0),
    .sel(and_s_state_mux_o0_a_o_al_n16),
    .o(data_mux_r1_2_o5));
  AL_MUX \data_mux_r1_2_b6/al_mux_b0_0_0  (
    .i0(data_mux_r1_1_o6),
    .i1(1'b0),
    .sel(and_s_state_mux_o0_a_o_al_n16),
    .o(data_mux_r1_2_o6));
  AL_MUX \data_mux_r1_2_b7/al_mux_b0_0_0  (
    .i0(data_mux_r1_1_o7),
    .i1(1'b0),
    .sel(and_s_state_mux_o0_a_o_al_n16),
    .o(data_mux_r1_2_o7));
  AL_MUX \data_mux_r1_3_b0/al_mux_b0_0_0  (
    .i0(data_mux_r1_2_o0),
    .i1(ram_q0),
    .sel(and_s_state_mux_o0_a_o_al_n17),
    .o(data_mux_r1_3_o0));
  AL_MUX \data_mux_r1_3_b1/al_mux_b0_0_0  (
    .i0(data_mux_r1_2_o1),
    .i1(ram_q1),
    .sel(and_s_state_mux_o0_a_o_al_n17),
    .o(data_mux_r1_3_o1));
  AL_MUX \data_mux_r1_3_b2/al_mux_b0_0_0  (
    .i0(data_mux_r1_2_o2),
    .i1(ram_q2),
    .sel(and_s_state_mux_o0_a_o_al_n17),
    .o(data_mux_r1_3_o2));
  AL_MUX \data_mux_r1_3_b3/al_mux_b0_0_0  (
    .i0(data_mux_r1_2_o3),
    .i1(ram_q3),
    .sel(and_s_state_mux_o0_a_o_al_n17),
    .o(data_mux_r1_3_o3));
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
    .i0(data_mux_r2_4_o4),
    .i1(ram_q4),
    .sel(s_state_mux_o0),
    .o(data_mux_r2_5_o4));
  AL_MUX \data_mux_r2_5_b5/al_mux_b0_0_0  (
    .i0(data_mux_r2_4_o5),
    .i1(ram_q5),
    .sel(s_state_mux_o0),
    .o(data_mux_r2_5_o5));
  AL_MUX \data_mux_r2_5_b6/al_mux_b0_0_0  (
    .i0(data_mux_r2_4_o6),
    .i1(ram_q6),
    .sel(s_state_mux_o0),
    .o(data_mux_r2_5_o6));
  AL_MUX \data_mux_r2_5_b7/al_mux_b0_0_0  (
    .i0(data_mux_r2_4_o7),
    .i1(ram_q7),
    .sel(s_state_mux_o0),
    .o(data_mux_r2_5_o7));
  not \empty_equal/none_diff  (empty_equal_o, \empty_equal/or_or_or_xor_i0[0]_i_o );
  or \empty_equal/or_or_or_xor_i0[0]_i  (\empty_equal/or_or_or_xor_i0[0]_i_o , \empty_equal/or_or_xor_i0[0]_i1[0_o , \empty_equal/or_or_xor_i0[5]_i1[5_o );
  or \empty_equal/or_or_xor_i0[0]_i1[0  (\empty_equal/or_or_xor_i0[0]_i1[0_o , \empty_equal/or_xor_i0[0]_i1[0]_o_o , \empty_equal/or_xor_i0[2]_i1[2]_o_o );
  or \empty_equal/or_or_xor_i0[5]_i1[5  (\empty_equal/or_or_xor_i0[5]_i1[5_o , \empty_equal/or_xor_i0[5]_i1[5]_o_o , \empty_equal/or_xor_i0[8]_i1[8]_o_o );
  or \empty_equal/or_xor_i0[0]_i1[0]_o  (\empty_equal/or_xor_i0[0]_i1[0]_o_o , \empty_equal/xor_i0[0]_i1[0]_o , \empty_equal/xor_i0[1]_i1[1]_o );
  or \empty_equal/or_xor_i0[2]_i1[2]_o  (\empty_equal/or_xor_i0[2]_i1[2]_o_o , \empty_equal/xor_i0[2]_i1[2]_o , \empty_equal/or_xor_i0[3]_i1[3]_o_o );
  or \empty_equal/or_xor_i0[3]_i1[3]_o  (\empty_equal/or_xor_i0[3]_i1[3]_o_o , \empty_equal/xor_i0[3]_i1[3]_o , \empty_equal/xor_i0[4]_i1[4]_o );
  or \empty_equal/or_xor_i0[5]_i1[5]_o  (\empty_equal/or_xor_i0[5]_i1[5]_o_o , \empty_equal/xor_i0[5]_i1[5]_o , \empty_equal/or_xor_i0[6]_i1[6]_o_o );
  or \empty_equal/or_xor_i0[6]_i1[6]_o  (\empty_equal/or_xor_i0[6]_i1[6]_o_o , \empty_equal/xor_i0[6]_i1[6]_o , \empty_equal/xor_i0[7]_i1[7]_o );
  or \empty_equal/or_xor_i0[8]_i1[8]_o  (\empty_equal/or_xor_i0[8]_i1[8]_o_o , \empty_equal/xor_i0[8]_i1[8]_o , \empty_equal/or_xor_i0[9]_i1[9]_o_o );
  or \empty_equal/or_xor_i0[9]_i1[9]_o  (\empty_equal/or_xor_i0[9]_i1[9]_o_o , \empty_equal/xor_i0[9]_i1[9]_o , \empty_equal/xor_i0[10]_i1[10]_o );
  xor \empty_equal/xor_i0[0]_i1[0]  (\empty_equal/xor_i0[0]_i1[0]_o , sync_delayed_wrptr_g0, rdptr_g0);
  xor \empty_equal/xor_i0[10]_i1[10]  (\empty_equal/xor_i0[10]_i1[10]_o , sync_delayed_wrptr_g10, rdptr_g10);
  xor \empty_equal/xor_i0[1]_i1[1]  (\empty_equal/xor_i0[1]_i1[1]_o , sync_delayed_wrptr_g1, rdptr_g1);
  xor \empty_equal/xor_i0[2]_i1[2]  (\empty_equal/xor_i0[2]_i1[2]_o , sync_delayed_wrptr_g2, rdptr_g2);
  xor \empty_equal/xor_i0[3]_i1[3]  (\empty_equal/xor_i0[3]_i1[3]_o , sync_delayed_wrptr_g3, rdptr_g3);
  xor \empty_equal/xor_i0[4]_i1[4]  (\empty_equal/xor_i0[4]_i1[4]_o , sync_delayed_wrptr_g4, rdptr_g4);
  xor \empty_equal/xor_i0[5]_i1[5]  (\empty_equal/xor_i0[5]_i1[5]_o , sync_delayed_wrptr_g5, rdptr_g5);
  xor \empty_equal/xor_i0[6]_i1[6]  (\empty_equal/xor_i0[6]_i1[6]_o , sync_delayed_wrptr_g6, rdptr_g6);
  xor \empty_equal/xor_i0[7]_i1[7]  (\empty_equal/xor_i0[7]_i1[7]_o , sync_delayed_wrptr_g7, rdptr_g7);
  xor \empty_equal/xor_i0[8]_i1[8]  (\empty_equal/xor_i0[8]_i1[8]_o , sync_delayed_wrptr_g8, rdptr_g8);
  xor \empty_equal/xor_i0[9]_i1[9]  (\empty_equal/xor_i0[9]_i1[9]_o , sync_delayed_wrptr_g9, rdptr_g9);
  not \empty_equal_test/none_diff  (empty_equal_test_o, \empty_equal_test/or_or_or_xor_i0[0]_i_o );
  or \empty_equal_test/or_or_or_xor_i0[0]_i  (\empty_equal_test/or_or_or_xor_i0[0]_i_o , \empty_equal_test/or_or_xor_i0[0]_i1[0_o , \empty_equal_test/or_or_xor_i0[5]_i1[5_o );
  or \empty_equal_test/or_or_xor_i0[0]_i1[0  (\empty_equal_test/or_or_xor_i0[0]_i1[0_o , \empty_equal_test/or_xor_i0[0]_i1[0]_o_o , \empty_equal_test/or_xor_i0[2]_i1[2]_o_o );
  or \empty_equal_test/or_or_xor_i0[5]_i1[5  (\empty_equal_test/or_or_xor_i0[5]_i1[5_o , \empty_equal_test/or_xor_i0[5]_i1[5]_o_o , \empty_equal_test/or_xor_i0[8]_i1[8]_o_o );
  or \empty_equal_test/or_xor_i0[0]_i1[0]_o  (\empty_equal_test/or_xor_i0[0]_i1[0]_o_o , \empty_equal_test/xor_i0[0]_i1[0]_o , \empty_equal_test/xor_i0[1]_i1[1]_o );
  or \empty_equal_test/or_xor_i0[2]_i1[2]_o  (\empty_equal_test/or_xor_i0[2]_i1[2]_o_o , \empty_equal_test/xor_i0[2]_i1[2]_o , \empty_equal_test/or_xor_i0[3]_i1[3]_o_o );
  or \empty_equal_test/or_xor_i0[3]_i1[3]_o  (\empty_equal_test/or_xor_i0[3]_i1[3]_o_o , \empty_equal_test/xor_i0[3]_i1[3]_o , \empty_equal_test/xor_i0[4]_i1[4]_o );
  or \empty_equal_test/or_xor_i0[5]_i1[5]_o  (\empty_equal_test/or_xor_i0[5]_i1[5]_o_o , \empty_equal_test/xor_i0[5]_i1[5]_o , \empty_equal_test/or_xor_i0[6]_i1[6]_o_o );
  or \empty_equal_test/or_xor_i0[6]_i1[6]_o  (\empty_equal_test/or_xor_i0[6]_i1[6]_o_o , \empty_equal_test/xor_i0[6]_i1[6]_o , \empty_equal_test/xor_i0[7]_i1[7]_o );
  or \empty_equal_test/or_xor_i0[8]_i1[8]_o  (\empty_equal_test/or_xor_i0[8]_i1[8]_o_o , \empty_equal_test/xor_i0[8]_i1[8]_o , \empty_equal_test/or_xor_i0[9]_i1[9]_o_o );
  or \empty_equal_test/or_xor_i0[9]_i1[9]_o  (\empty_equal_test/or_xor_i0[9]_i1[9]_o_o , \empty_equal_test/xor_i0[9]_i1[9]_o , \empty_equal_test/xor_i0[10]_i1[10]_o );
  xor \empty_equal_test/xor_i0[0]_i1[0]  (\empty_equal_test/xor_i0[0]_i1[0]_o , sync_delayed_wrptr_g0, rdptr_g_test0);
  xor \empty_equal_test/xor_i0[10]_i1[10]  (\empty_equal_test/xor_i0[10]_i1[10]_o , sync_delayed_wrptr_g10, rdptr_g_test10);
  xor \empty_equal_test/xor_i0[1]_i1[1]  (\empty_equal_test/xor_i0[1]_i1[1]_o , sync_delayed_wrptr_g1, rdptr_g_test1);
  xor \empty_equal_test/xor_i0[2]_i1[2]  (\empty_equal_test/xor_i0[2]_i1[2]_o , sync_delayed_wrptr_g2, rdptr_g_test2);
  xor \empty_equal_test/xor_i0[3]_i1[3]  (\empty_equal_test/xor_i0[3]_i1[3]_o , sync_delayed_wrptr_g3, rdptr_g_test3);
  xor \empty_equal_test/xor_i0[4]_i1[4]  (\empty_equal_test/xor_i0[4]_i1[4]_o , sync_delayed_wrptr_g4, rdptr_g_test4);
  xor \empty_equal_test/xor_i0[5]_i1[5]  (\empty_equal_test/xor_i0[5]_i1[5]_o , sync_delayed_wrptr_g5, rdptr_g_test5);
  xor \empty_equal_test/xor_i0[6]_i1[6]  (\empty_equal_test/xor_i0[6]_i1[6]_o , sync_delayed_wrptr_g6, rdptr_g_test6);
  xor \empty_equal_test/xor_i0[7]_i1[7]  (\empty_equal_test/xor_i0[7]_i1[7]_o , sync_delayed_wrptr_g7, rdptr_g_test7);
  xor \empty_equal_test/xor_i0[8]_i1[8]  (\empty_equal_test/xor_i0[8]_i1[8]_o , sync_delayed_wrptr_g8, rdptr_g_test8);
  xor \empty_equal_test/xor_i0[9]_i1[9]  (\empty_equal_test/xor_i0[9]_i1[9]_o , sync_delayed_wrptr_g9, rdptr_g_test9);
  not empty_equal_test_o_inv (empty_equal_test_o_neg, empty_equal_test_o);
  not empty_equal_test_o_neg_inv (empty_equal_test_o_neg_neg, empty_equal_test_o_neg);
  AL_MUX \empty_r_mux/al_mux_b0_0_0  (
    .i0(1'b1),
    .i1(and_empty_equal_test_o),
    .sel(curr_state0),
    .o(\empty_r_mux/B0_0 ));
  AL_MUX \empty_r_mux/al_mux_b0_1_0  (
    .i0(\empty_r_mux/B0_0 ),
    .i1(\addr_inc_mux/B0_2 ),
    .sel(curr_state1),
    .o(\empty_r_mux/B1_0 ));
  AL_MUX \empty_r_mux/al_mux_b0_2_0  (
    .i0(\empty_r_mux/B1_0 ),
    .i1(1'b0),
    .sel(curr_state2),
    .o(empty_r_mux_o0));
  // address_offset=0;data_offset=0;depth=1024;width=8;num_section=1;width_per_section=8;section_size=8;working_depth=1024;working_width=9;working_numbyte=1;mode_ecc=0;address_step=1;bytes_in_per_section=1;
  EG_PHY_BRAM #(
    .CEAMUX("1"),
    .CSA0("1"),
    .CSA1("1"),
    .CSA2("1"),
    .CSB0("1"),
    .CSB1("1"),
    .CSB2("1"),
    .DATA_WIDTH_A("9"),
    .DATA_WIDTH_B("9"),
    .MODE("DP8K"),
    .OCEAMUX("1"),
    .OCEBMUX("1"),
    .REGMODE_A("NOREG"),
    .REGMODE_B("NOREG"),
    .RESETMODE("SYNC"),
    .WEBMUX("0"),
    .WRITEMODE_A("NORMAL"),
    .WRITEMODE_B("NORMAL"))
    fifo_bram_1024x8_sub_000000_000 (
    .addra({xor_wrptr_g10_wrptr__o,wrptr_g8,wrptr_g7,wrptr_g6,wrptr_g5,wrptr_g4,wrptr_g3,wrptr_g2,wrptr_g1,wrptr_g0,3'b111}),
    .addrb({xor_rdptr_g_test10_r_o,rdptr_g_test8,rdptr_g_test7,rdptr_g_test6,rdptr_g_test5,rdptr_g_test4,rdptr_g_test3,rdptr_g_test2,rdptr_g_test1,rdptr_g_test0,3'b111}),
    .ceb(and_addr_inc_empty_e_o),
    .clka(clk),
    .clkb(clk),
    .dia({open_n54,di}),
    .rsta(rst),
    .rstb(rst),
    .wea(and_we_full_equal_o__o),
    .dob({open_n76,ram_q7,ram_q6,ram_q5,ram_q4,ram_q3,ram_q2,ram_q1,ram_q0}));
  not \full_equal/none_diff  (full_flag, \full_equal/or_or_or_xor_i0[0]_i_o );
  or \full_equal/or_or_or_xor_i0[0]_i  (\full_equal/or_or_or_xor_i0[0]_i_o , \full_equal/or_or_xor_i0[0]_i1[0_o , \full_equal/or_or_xor_i0[5]_i1[5_o );
  or \full_equal/or_or_xor_i0[0]_i1[0  (\full_equal/or_or_xor_i0[0]_i1[0_o , \full_equal/or_xor_i0[0]_i1[0]_o_o , \full_equal/or_xor_i0[2]_i1[2]_o_o );
  or \full_equal/or_or_xor_i0[5]_i1[5  (\full_equal/or_or_xor_i0[5]_i1[5_o , \full_equal/or_xor_i0[5]_i1[5]_o_o , \full_equal/or_xor_i0[8]_i1[8]_o_o );
  or \full_equal/or_xor_i0[0]_i1[0]_o  (\full_equal/or_xor_i0[0]_i1[0]_o_o , \full_equal/xor_i0[0]_i1[0]_o , \full_equal/xor_i0[1]_i1[1]_o );
  or \full_equal/or_xor_i0[2]_i1[2]_o  (\full_equal/or_xor_i0[2]_i1[2]_o_o , \full_equal/xor_i0[2]_i1[2]_o , \full_equal/or_xor_i0[3]_i1[3]_o_o );
  or \full_equal/or_xor_i0[3]_i1[3]_o  (\full_equal/or_xor_i0[3]_i1[3]_o_o , \full_equal/xor_i0[3]_i1[3]_o , \full_equal/xor_i0[4]_i1[4]_o );
  or \full_equal/or_xor_i0[5]_i1[5]_o  (\full_equal/or_xor_i0[5]_i1[5]_o_o , \full_equal/xor_i0[5]_i1[5]_o , \full_equal/or_xor_i0[6]_i1[6]_o_o );
  or \full_equal/or_xor_i0[6]_i1[6]_o  (\full_equal/or_xor_i0[6]_i1[6]_o_o , \full_equal/xor_i0[6]_i1[6]_o , \full_equal/xor_i0[7]_i1[7]_o );
  or \full_equal/or_xor_i0[8]_i1[8]_o  (\full_equal/or_xor_i0[8]_i1[8]_o_o , \full_equal/xor_i0[8]_i1[8]_o , \full_equal/or_xor_i0[9]_i1[9]_o_o );
  or \full_equal/or_xor_i0[9]_i1[9]_o  (\full_equal/or_xor_i0[9]_i1[9]_o_o , \full_equal/xor_i0[9]_i1[9]_o , \full_equal/xor_i0[10]_i1[10]_o );
  xor \full_equal/xor_i0[0]_i1[0]  (\full_equal/xor_i0[0]_i1[0]_o , wrptr_g0, sync_rdptr_g0);
  xor \full_equal/xor_i0[10]_i1[10]  (\full_equal/xor_i0[10]_i1[10]_o , wrptr_g10, sync_rdptr_g10_neg);
  xor \full_equal/xor_i0[1]_i1[1]  (\full_equal/xor_i0[1]_i1[1]_o , wrptr_g1, sync_rdptr_g1);
  xor \full_equal/xor_i0[2]_i1[2]  (\full_equal/xor_i0[2]_i1[2]_o , wrptr_g2, sync_rdptr_g2);
  xor \full_equal/xor_i0[3]_i1[3]  (\full_equal/xor_i0[3]_i1[3]_o , wrptr_g3, sync_rdptr_g3);
  xor \full_equal/xor_i0[4]_i1[4]  (\full_equal/xor_i0[4]_i1[4]_o , wrptr_g4, sync_rdptr_g4);
  xor \full_equal/xor_i0[5]_i1[5]  (\full_equal/xor_i0[5]_i1[5]_o , wrptr_g5, sync_rdptr_g5);
  xor \full_equal/xor_i0[6]_i1[6]  (\full_equal/xor_i0[6]_i1[6]_o , wrptr_g6, sync_rdptr_g6);
  xor \full_equal/xor_i0[7]_i1[7]  (\full_equal/xor_i0[7]_i1[7]_o , wrptr_g7, sync_rdptr_g7);
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
    .b(sync_rdptr_g_bin_d17),
    .c(\wrusedw_sub/c7 ),
    .o({\wrusedw_sub/c8 ,wrusedw[7]}));
  AL_MAP_ADDER #(
    .ALUTYPE("SUB"))
    \wrusedw_sub/u8  (
    .a(wrptr_g_bin_d18),
    .b(sync_rdptr_g_bin_d18),
    .c(\wrusedw_sub/c8 ),
    .o({\wrusedw_sub/c9 ,wrusedw[8]}));
  AL_MAP_ADDER #(
    .ALUTYPE("SUB"))
    \wrusedw_sub/u9  (
    .a(wrptr_g_bin_d19),
    .b(sync_rdptr_g_bin_d19),
    .c(\wrusedw_sub/c9 ),
    .o({\wrusedw_sub/c10 ,wrusedw[9]}));
  AL_MAP_ADDER #(
    .ALUTYPE("SUB_CARRY"))
    \wrusedw_sub/ucin  (
    .a(1'b0),
    .o({\wrusedw_sub/c0 ,open_n84}));
  xor xor_q10_al_n29_and_q (xor_q10_al_n29_and_q_o, q10_al_n29, and_q9_al_n28_and_an_o);
  xor xor_q10_al_n73_and_q (xor_q10_al_n73_and_q_o, q10_al_n73, and_q9_al_n72_and_an_o);
  xor xor_q10_and_q9_and_a (xor_q10_and_q9_and_a_o, q10, and_q9_and_and_and_a_o);
  xor xor_q11_al_n30_and_o (xor_q11_al_n30_and_o_o, q11_al_n30, and_or_q11_al_n30_q1_o);
  xor xor_q11_al_n74_and_o (xor_q11_al_n74_and_o_o, q11_al_n74, and_or_q11_al_n74_q1_o);
  xor xor_q11_and_or_q11_q (xor_q11_and_or_q11_q_o, q11, and_or_q11_q10_o_and_o);
  xor xor_q1_al_n20_and_q0 (xor_q1_al_n20_and_q0_o, q1_al_n20, q0_al_n19);
  xor xor_q1_al_n64_and_q0 (xor_q1_al_n64_and_q0_o, q1_al_n64, q0_al_n63);
  xor xor_q1_and_q0__al_n1 (xor_q1_and_q0__al_n1_o, q1, q0);
  xor xor_q2_al_n21_and_q1 (xor_q2_al_n21_and_q1_o, q2_al_n21, and_q1_al_n20_and__a_o);
  xor xor_q2_al_n65_and_q1 (xor_q2_al_n65_and_q1_o, q2_al_n65, and_q1_al_n64_and__a_o);
  xor xor_q2_and_q1_and__a (xor_q2_and_q1_and__a_o, q2, and_q1_and__al_n1_q0_o);
  xor xor_q3_al_n22_and_q2 (xor_q3_al_n22_and_q2_o, q3_al_n22, and_q2_al_n21_and_an_o);
  xor xor_q3_al_n66_and_q2 (xor_q3_al_n66_and_q2_o, q3_al_n66, and_q2_al_n65_and_an_o);
  xor xor_q3_and_q2_and_an (xor_q3_and_q2_and_an_o, q3, and_q2_and_and__al_n_o);
  xor xor_q4_al_n23_and_q3 (xor_q4_al_n23_and_q3_o, q4_al_n23, and_q3_al_n22_and_an_o);
  xor xor_q4_al_n67_and_q3 (xor_q4_al_n67_and_q3_o, q4_al_n67, and_q3_al_n66_and_an_o);
  xor xor_q4_and_q3_and_an (xor_q4_and_q3_and_an_o, q4, and_q3_and_and_and___o);
  xor xor_q5_al_n24_and_q4 (xor_q5_al_n24_and_q4_o, q5_al_n24, and_q4_al_n23_and_an_o);
  xor xor_q5_al_n68_and_q4 (xor_q5_al_n68_and_q4_o, q5_al_n68, and_q4_al_n67_and_an_o);
  xor xor_q5_and_q4_and_an (xor_q5_and_q4_and_an_o, q5, and_q4_and_and_and_a_o);
  xor xor_q6_al_n25_and_q5 (xor_q6_al_n25_and_q5_o, q6_al_n25, and_q5_al_n24_and_an_o);
  xor xor_q6_al_n69_and_q5 (xor_q6_al_n69_and_q5_o, q6_al_n69, and_q5_al_n68_and_an_o);
  xor xor_q6_and_q5_and_an (xor_q6_and_q5_and_an_o, q6, and_q5_and_and_and_a_o);
  xor xor_q7_al_n26_and_q6 (xor_q7_al_n26_and_q6_o, q7_al_n26, and_q6_al_n25_and_an_o);
  xor xor_q7_al_n70_and_q6 (xor_q7_al_n70_and_q6_o, q7_al_n70, and_q6_al_n69_and_an_o);
  xor xor_q7_and_q6_and_an (xor_q7_and_q6_and_an_o, q7, and_q6_and_and_and_a_o);
  xor xor_q8_al_n27_and_q7 (xor_q8_al_n27_and_q7_o, q8_al_n27, and_q7_al_n26_and_an_o);
  xor xor_q8_al_n71_and_q7 (xor_q8_al_n71_and_q7_o, q8_al_n71, and_q7_al_n70_and_an_o);
  xor xor_q8_and_q7_and_an (xor_q8_and_q7_and_an_o, q8, and_q7_and_and_and_a_o);
  xor xor_q9_al_n28_and_q8 (xor_q9_al_n28_and_q8_o, q9_al_n28, and_q8_al_n27_and_an_o);
  xor xor_q9_al_n72_and_q8 (xor_q9_al_n72_and_q8_o, q9_al_n72, and_q8_al_n71_and_an_o);
  xor xor_q9_and_q8_and_an (xor_q9_and_q8_and_an_o, q9, and_q8_and_and_and_a_o);
  xor xor_rdptr_g10_rdptr__al_u67 (xor_rdptr_g10_rdptr__o_al_n127, rdptr_g10, rdptr_g9);
  xor xor_rdptr_g_test10_r (xor_rdptr_g_test10_r_o, rdptr_g_test10, rdptr_g_test9);
  xor xor_sync_delayed_wrp (xor_sync_delayed_wrp_o, sync_delayed_wrptr_g10, sync_delayed_wrptr_g9);
  xor xor_sync_rdptr_g10_s (xor_sync_rdptr_g10_s_o, sync_rdptr_g10, sync_rdptr_g9);
  xor xor_wrptr_g10_wrptr_ (xor_wrptr_g10_wrptr__o, wrptr_g10, wrptr_g9);
  xor xor_xor_rdptr_g10_rd (xor_xor_rdptr_g10_rd_o, xor_rdptr_g10_rdptr__o_al_n127, rdptr_g8);
  xor xor_xor_sync_delayed (xor_xor_sync_delayed_o, xor_sync_delayed_wrp_o, sync_delayed_wrptr_g8);
  xor xor_xor_sync_rdptr_g (xor_xor_sync_rdptr_g_o, xor_sync_rdptr_g10_s_o, sync_rdptr_g8);
  xor xor_xor_wrptr_g10_wr (xor_xor_wrptr_g10_wr_o, xor_wrptr_g10_wrptr__o, wrptr_g8);
  xor xor_xor_xor_rdptr_g1 (xor_xor_xor_rdptr_g1_o, xor_xor_rdptr_g10_rd_o, rdptr_g7);
  xor xor_xor_xor_sync_del (xor_xor_xor_sync_del_o, xor_xor_sync_delayed_o, sync_delayed_wrptr_g7);
  xor xor_xor_xor_sync_rdp (xor_xor_xor_sync_rdp_o, xor_xor_sync_rdptr_g_o, sync_rdptr_g7);
  xor xor_xor_xor_wrptr_g1 (xor_xor_xor_wrptr_g1_o, xor_xor_wrptr_g10_wr_o, wrptr_g7);
  xor xor_xor_xor_xor_rdpt (xor_xor_xor_xor_rdpt_o, xor_xor_xor_rdptr_g1_o, rdptr_g6);
  xor xor_xor_xor_xor_sync (xor_xor_xor_xor_sync_o, xor_xor_xor_sync_rdp_o, sync_rdptr_g6);
  xor xor_xor_xor_xor_sync_al_u59 (xor_xor_xor_xor_sync_o_al_n120, xor_xor_xor_sync_del_o, sync_delayed_wrptr_g6);
  xor xor_xor_xor_xor_wrpt (xor_xor_xor_xor_wrpt_o, xor_xor_xor_wrptr_g1_o, wrptr_g6);
  xor xor_xor_xor_xor_xor_ (xor_xor_xor_xor_xor__o, xor_xor_xor_xor_sync_o, sync_rdptr_g5);
  xor xor_xor_xor_xor_xor__al_u46 (xor_xor_xor_xor_xor__o_al_n108, xor_xor_xor_xor_xor__o, sync_rdptr_g4);
  xor xor_xor_xor_xor_xor__al_u47 (xor_xor_xor_xor_xor__o_al_n109, xor_xor_xor_xor_xor__o_al_n108, sync_rdptr_g3);
  xor xor_xor_xor_xor_xor__al_u48 (xor_xor_xor_xor_xor__o_al_n110, xor_xor_xor_xor_xor__o_al_n109, sync_rdptr_g2);
  xor xor_xor_xor_xor_xor__al_u49 (xor_xor_xor_xor_xor__o_al_n111, xor_xor_xor_xor_xor__o_al_n110, sync_rdptr_g1);
  xor xor_xor_xor_xor_xor__al_u50 (xor_xor_xor_xor_xor__o_al_n112, xor_xor_xor_xor_xor__o_al_n111, sync_rdptr_g0);
  xor xor_xor_xor_xor_xor__al_u52 (xor_xor_xor_xor_xor__o_al_n114, xor_xor_xor_xor_wrpt_o, wrptr_g5);
  xor xor_xor_xor_xor_xor__al_u53 (xor_xor_xor_xor_xor__o_al_n115, xor_xor_xor_xor_xor__o_al_n114, wrptr_g4);
  xor xor_xor_xor_xor_xor__al_u54 (xor_xor_xor_xor_xor__o_al_n116, xor_xor_xor_xor_xor__o_al_n115, wrptr_g3);
  xor xor_xor_xor_xor_xor__al_u55 (xor_xor_xor_xor_xor__o_al_n117, xor_xor_xor_xor_xor__o_al_n116, wrptr_g2);
  xor xor_xor_xor_xor_xor__al_u56 (xor_xor_xor_xor_xor__o_al_n118, xor_xor_xor_xor_xor__o_al_n117, wrptr_g1);
  xor xor_xor_xor_xor_xor__al_u57 (xor_xor_xor_xor_xor__o_al_n119, xor_xor_xor_xor_xor__o_al_n118, wrptr_g0);
  xor xor_xor_xor_xor_xor__al_u60 (xor_xor_xor_xor_xor__o_al_n121, xor_xor_xor_xor_sync_o_al_n120, sync_delayed_wrptr_g5);
  xor xor_xor_xor_xor_xor__al_u61 (xor_xor_xor_xor_xor__o_al_n122, xor_xor_xor_xor_xor__o_al_n121, sync_delayed_wrptr_g4);
  xor xor_xor_xor_xor_xor__al_u62 (xor_xor_xor_xor_xor__o_al_n123, xor_xor_xor_xor_xor__o_al_n122, sync_delayed_wrptr_g3);
  xor xor_xor_xor_xor_xor__al_u63 (xor_xor_xor_xor_xor__o_al_n124, xor_xor_xor_xor_xor__o_al_n123, sync_delayed_wrptr_g2);
  xor xor_xor_xor_xor_xor__al_u64 (xor_xor_xor_xor_xor__o_al_n125, xor_xor_xor_xor_xor__o_al_n124, sync_delayed_wrptr_g1);
  xor xor_xor_xor_xor_xor__al_u65 (xor_xor_xor_xor_xor__o_al_n126, xor_xor_xor_xor_xor__o_al_n125, sync_delayed_wrptr_g0);
  xor xor_xor_xor_xor_xor__al_u68 (xor_xor_xor_xor_xor__o_al_n128, xor_xor_xor_xor_rdpt_o, rdptr_g5);
  xor xor_xor_xor_xor_xor__al_u69 (xor_xor_xor_xor_xor__o_al_n129, xor_xor_xor_xor_xor__o_al_n128, rdptr_g4);
  xor xor_xor_xor_xor_xor__al_u70 (xor_xor_xor_xor_xor__o_al_n130, xor_xor_xor_xor_xor__o_al_n129, rdptr_g3);
  xor xor_xor_xor_xor_xor__al_u71 (xor_xor_xor_xor_xor__o_al_n131, xor_xor_xor_xor_xor__o_al_n130, rdptr_g2);
  xor xor_xor_xor_xor_xor__al_u72 (xor_xor_xor_xor_xor__o_al_n132, xor_xor_xor_xor_xor__o_al_n131, rdptr_g1);
  xor xor_xor_xor_xor_xor__al_u73 (xor_xor_xor_xor_xor__o_al_n133, xor_xor_xor_xor_xor__o_al_n132, rdptr_g0);

endmodule 

module AL_DFF_X
  (
  ar,
  as,
  clk,
  d,
  en,
  sr,
  ss,
  q
  );

  input ar;
  input as;
  input clk;
  input d;
  input en;
  input sr;
  input ss;
  output q;

  wire enout;
  wire srout;
  wire ssout;

  AL_MUX u_en (
    .i0(q),
    .i1(d),
    .sel(en),
    .o(enout));
  AL_MUX u_reset (
    .i0(ssout),
    .i1(1'b0),
    .sel(sr),
    .o(srout));
  AL_DFF u_seq (
    .clk(clk),
    .d(srout),
    .reset(ar),
    .set(as),
    .q(q));
  AL_MUX u_set (
    .i0(enout),
    .i1(1'b1),
    .sel(ss),
    .o(ssout));

endmodule 

module AL_MUX
  (
  input i0,
  input i1,
  input sel,
  output o
  );

  wire not_sel, sel_i0, sel_i1;
  not u0 (not_sel, sel);
  and u1 (sel_i1, sel, i1);
  and u2 (sel_i0, not_sel, i0);
  or u3 (o, sel_i1, sel_i0);

endmodule

module AL_DFF
  (
  input reset,
  input set,
  input clk,
  input d,
  output reg q
  );

  parameter INI = 1'b0;

  // synthesis translate_off
  tri0 gsrn = glbl.gsrn;

  always @(gsrn)
  begin
    if(!gsrn)
      assign q = INI;
    else
      deassign q;
  end
  // synthesis translate_on

  always @(posedge reset or posedge set or posedge clk)
  begin
    if (reset)
      q <= 1'b0;
    else if (set)
      q <= 1'b1;
    else
      q <= d;
  end

endmodule
