qianshuyuank/MLKPAI-FMin01/01_start/02_peripheral_demo/03_i2c_eeprom/uisrc/02_sim/eeprom.v

/*******************************MILIANKE*******************************
*Company : MiLianKe Electronic Technology Co., Ltd.
*WebSite:https://www.milianke.com
*TechWeb:https://www.uisrc.com
*tmall-shop:https://milianke.tmall.com
*jd-shop:https://milianke.jd.com
*taobao-shop1: https://milianke.taobao.com
*Create Date: 2024/08/20
*Module Name:uii2c
*File Name:uii2c.v
*Description: 
*The reference demo provided by Milianke is only used for learning. 
*We cannot ensure that the demo itself is free of bugs, so users 
*should be responsible for the technical problems and consequences
*caused by the use of their own products.
*Copyright: Copyright (c) MiLianKe
*All rights reserved.
*Revision: 1.1
*Signal description
*1) I_ input
*2) O_ output
*3) IO_ input output
*4) S_ system internal signal
*5) _n activ low
*6) _dg debug signal 
*7) _r delay or register
*8) _s state mechine
*********************************************************************/
`timescale 1ns / 1ns
`define timeslice 20
module eeprom(
input scl,
inout sda);
reg out_flag;
reg [7:0] memory[2047:0];
reg[10:0] address;
reg[7:0] memory_buf;
reg [7:0] sda_buf;
reg [7:0] shift;
reg [7:0] addr_byte;
reg [7:0] ctrl_byte;
reg [1:0] State;
integer i;

// ----------------------------------------------
parameter r7=8'b10101111,w7=8'b10101110,
          r6=8'b10101101,w6=8'b10101100,
             r5=8'b10101011,w5=8'b10101010,
             r4=8'b10101001,w4=8'b10101000,
             r3=8'b10100111,w3=8'b10100110,
          r2=8'b10100101,w2=8'b10100100,
             r1=8'b10100011,w1=8'b10100010,
             r0=8'b10100001,w0=8'b10100000;
             
//---------------------------------------------------

assign sda= (out_flag == 1)?sda_buf[7]:1'bz;
//--------------------瀵勫瓨鍣ㄥ拰瀛樺偍鍣ㄥ垵濮嬪寲------------------------------
initial
begin
addr_byte   =0;
ctrl_byte   =0;
out_flag    =0;
sda_buf     =0;
State       =2'b00;
memory_buf  =0;
address     =0;
shift       =0;
for(i=0;i<=2047;i=i+1)
memory[i]=0;
end

//////--------------鍚姩淇″彿妫€娴?-------------
always @(negedge sda)
            if(scl == 1)
             begin
                State=State+1;
                if(State==2'b11)
                 disable write_to_eeprm;
             end                
 /////-------------------涓荤姸鎬佹満-----------------------
always @(posedge sda)
                if(scl == 1)
                stop_W_R;
                else
                begin
                casex(State)  
                2'b01:
                begin
                read_in;
                    if(ctrl_byte == w7||ctrl_byte == w6|| ctrl_byte == w5
                    || ctrl_byte == w4 || ctrl_byte == w3 || ctrl_byte == w2 ||ctrl_byte == w1 ||ctrl_byte == w0)
                     begin
                        State = 2'b10;
                        write_to_eeprm;
                     end
                     else 
                        State = 2'b00;
                end
                     
                2'b11:
                     read_from_eeprm;
                     default:
                           State=2'b00;
                     endcase
                     end

                
//--------------鎿嶄綔鍋滄------------------
task stop_W_R;
       begin
         
         State = 2'b00;
         addr_byte  =0;
         ctrl_byte  =0;
         out_flag   =0;
         sda_buf   =0;
         end
    endtask
//----------------璇昏繘鎺у埗瀛楀拰瀛樺偍鍗曞厓鍦板潃-------------------
    task read_in;
    begin
    shift_in(ctrl_byte);
    shift_in(addr_byte);
    end
    endtask
    //-------------EEPROM--------------------
    task write_to_eeprm;
    begin
    shift_in(memory_buf);
    address    ={ctrl_byte[3:1],addr_byte};
    memory[address]  = memory_buf;
    $display("eeprm---memory[%0h]=%0h",address,memory[address]);
    State= 2'b00;
    end
    endtask
    
    
    //-------------EEPROM璇绘搷浣淿______________________
    task read_from_eeprm;
    begin
    shift_in(ctrl_byte);
    if(ctrl_byte == r7 || ctrl_byte == r6 || ctrl_byte == r5 || ctrl_byte == r4 || ctrl_byte == r3 || ctrl_byte == r2
        || ctrl_byte == r1 || ctrl_byte == r0)
         begin
         address = {ctrl_byte[3:1],addr_byte};
         sda_buf =memory [address];
         shift_out;
         State = 2'b00;
    end
    end
    endtask
    
    // ---SDA 鏁版嵁绾夸笂鐨勬暟鎹瓨鍏ュ瘎瀛樺櫒 锛屾暟鎹湪SCL鐨勯珮鐢靛钩鏈夋晥------------------
    task shift_in;
    output[7:0] shift;
    begin
    @(posedge scl) shift[7]=sda;
    @(posedge scl) shift[6]=sda;
    @(posedge scl) shift[5]=sda;
    @(posedge scl) shift[4]=sda;
    @(posedge scl) shift[3]=sda;
    @(posedge scl) shift[2]=sda;
    @(posedge scl) shift[1]=sda;
    @(posedge scl) shift[0]=sda;
    @(negedge scl) //ACK
    begin
    #`timeslice;//妯℃嫙鑺墖鐨勫欢杩熻緭鍑篈CK
    out_flag = 1;
    sda_buf  =0;
    end
    @(negedge scl)//缁撴潫ACK
    #`timeslice out_flag  = 0;
    end
    endtask
    //----------EEPROM瀛樺偍鍣ㄤ腑鐨勬暟鎹€氳繃SDA鏁版嵁绾胯緭鍑猴紝鏁版嵁鍦⊿CL浣庣數骞虫椂鍙樺寲
   task shift_out;
    begin
    out_flag= 1;
    for(i=6;i>=0;i=i-1)
    begin
    
    @(negedge scl);
    # `timeslice;
    sda_buf = sda_buf<<1;
    end
   @(negedge scl) # `timeslice sda_buf[7]=1;
    @(negedge scl) # `timeslice out_flag=0;
    end
    endtask
    endmodule 
