qianshuyuank/MLKPAI-FMin01/01_start/02_peripheral_demo/05_rgb2hdmi_output/hdmi_720p/uisrc/03_ip/al_ui_hdmi_tx/SerializerN_1_lvds.vhd

`protect begin

-----------------------------------------------------
-- Company: anlgoic
-- Author: 	xg 
-----------------------------------------------------


library IEEE;
use IEEE.STD_LOGIC_1164.ALL;


entity Serial_N_1_lvds is
	 Generic ( 	N : NATURAL := 10;
					FAMILY : STRING := "EG4");
    Port ( 	
			DP_I : in  STD_LOGIC_VECTOR (N-1 downto 0);
			PCLK : in  STD_LOGIC; 
			SCLK : in STD_LOGIC; 

			DSP_O : out  STD_LOGIC
		);
end Serial_N_1_lvds;


architecture Behavioral of Serial_N_1_lvds is


component PH1_LOGIC_ODDR is 
generic (
    ASYNCRST : string := "ENABLE"
    );
port (
    q : out std_logic ;
    clk : in std_logic ;
    d1 : in std_logic ;
    d0 : in std_logic ;
    rst : in std_logic 
    );
end component;

component EG_LOGIC_ODDR is 
generic (
    ASYNCRST : string := "ENABLE"
    );
port (
    q : out std_logic ;
    clk : in std_logic ;
    d1 : in std_logic ;
    d0 : in std_logic ;
    rst : in std_logic 
    );
end component;

component AL_LOGIC_ODDR is 
generic (
    ASYNCRST : string := "ENABLE"
    );
port (
    q : out std_logic ;
    clk : in std_logic ;
    d1 : in std_logic ;
    d0 : in std_logic ;
    rst : in std_logic 
    );
end component;

component EF2_LOGIC_ODDR is 
generic (
    ASYNCRST : string := "ENABLE"
    );
port (
    q : out std_logic ;
    clk : in std_logic ;
    d1 : in std_logic ;
    d0 : in std_logic ;
    rst : in std_logic 
    );
end component;

component EF3_LOGIC_ODDR is 
generic (
    ASYNCRST : string := "ENABLE"
    );
port (
    q : out std_logic ;
    clk : in std_logic ;
    d1 : in std_logic ;
    d0 : in std_logic ;
    rst : in std_logic 
    );
end component;

signal  LVDS_SDOUT_vld,LVDS_SDOUT_vld_q,LVDS_SDOUT_vld_qq,sclk_dat_lat,sclk_dat_lat_1d,sclk_dat_lat_2d,sclk_dat_lat_3d: std_logic:='0';
signal  tx_pdat : std_logic_vector(N-1 downto 0) ;
signal  tx_sdat,tx_sdat_1d : std_logic_vector(1 downto 0) ;
signal  tx_out: std_logic:='0';

begin


--------------------------------  lvds  -------------------------------------------

process(PCLK) 
begin
    if rising_edge(PCLK) then  
	      LVDS_SDOUT_vld <=  not LVDS_SDOUT_vld;
    end if;
end process;    

process(SCLK) 
  begin
    if rising_edge(SCLK) then  
		    LVDS_SDOUT_vld_q   <=  LVDS_SDOUT_vld;
			LVDS_SDOUT_vld_qq  <=  LVDS_SDOUT_vld_q;
			sclk_dat_lat <= LVDS_SDOUT_vld_q xor LVDS_SDOUT_vld_qq; 
			sclk_dat_lat_1d <= sclk_dat_lat;
			sclk_dat_lat_2d <= sclk_dat_lat_1d;
			sclk_dat_lat_3d <= sclk_dat_lat_2d;
    end if;        
end process;

process(SCLK) 
begin
    if rising_edge(SCLK) then 
        if sclk_dat_lat_2d = '1' then
           tx_pdat <= DP_I(0) & DP_I(1) & DP_I(2) & DP_I(3) & DP_I(4) & DP_I(5) & DP_I(6) & DP_I(7) & DP_I(8) & DP_I(9) ; 
        else
           tx_pdat <= tx_pdat(N-3 downto 0) & '0' & '0';  
        end if;        
    end if;
end process; 

process(SCLK) 
begin
    if rising_edge(SCLK) then 
        tx_sdat <= not tx_pdat(N-1 downto N-2) ;
        tx_sdat_1d <= tx_sdat;
    end if;
end process;


eg: if FAMILY = "EG4" generate

oddr_snd : EG_LOGIC_ODDR 
port map(
    q => DSP_O,
    clk => SCLK,
    d1 => tx_sdat_1d(0),
    d0 => tx_sdat_1d(1),
    rst => '0'
    );
end generate eg;

ph1: if FAMILY = "PH1" generate

oddr_snd : PH1_LOGIC_ODDR 
port map(
    q => DSP_O,
    clk => SCLK,
    d1 => tx_sdat_1d(0),
    d0 => tx_sdat_1d(1),
    rst => '0'
    );
end generate ph1;

al: if FAMILY = "AL3" generate

oddr_snd : AL_LOGIC_ODDR 
port map(
    q => DSP_O,
    clk => SCLK,
    d1 => tx_sdat_1d(0),
    d0 => tx_sdat_1d(1),
    rst => '0'
    );
end generate al;


ef2: if FAMILY = "EF2" generate

oddr_snd : EF2_LOGIC_ODDR 
port map(
    q => DSP_O,
    clk => SCLK,
    d1 => tx_sdat_1d(0),
    d0 => tx_sdat_1d(1),
    rst => '0'
    );
end generate ef2;

ef3: if FAMILY = "EF3" generate

oddr_snd : EF3_LOGIC_ODDR 
port map(
    q => DSP_O,
    clk => SCLK,
    d1 => tx_sdat_1d(0),
    d0 => tx_sdat_1d(1),
    rst => '0'
    );
end generate ef3;

end Behavioral;

`protect end
