qianshuyuank/MLKPAI-FMin01/01_start/02_peripheral_demo/07_sdram_fdma/sdram_fdma_gc0308/uisrc/03_ip/uiov5640cfg/uii2c.v

`timescale 1ns / 1ps

//////////////////////////////////////////////////////////////////////////////////
/*
Company : Liyang Milian Electronic Technology Co., Ltd.
Brand:锟斤拷锟斤拷锟?msxbo)
Technical forum??uisrc.com
taobao: osrc.taobao.com
Create Date: 2019/02/27 22:09:55
Module Name: iic controller
Description: 
This iic master controller supports random address reading and writing, 
and page reading and writing. Supports up to 255 byte writes (including 1 byte 
of device address), and supports up to 255 byte reads.
 255 byte reads.
Copyright: Copyright (c) msxbo
Revision: 1.0
Signal description??
1) _i input
2) _o output
3) _n activ low
4) _dg debug signal 
5) _r delay or register
6) _s state mechine
*/
////////////////////////////////////////////////////////////////////////////////
module uii2c#
(
parameter WMEN_LEN = 8'd0,
parameter RMEN_LEN = 8'd0,
parameter CLK_DIV  = 16'd499
)
(
input  clk_i,
input  rst_n,
output reg iic_scl = 1'b0,
inout  iic_sda,
input  [WMEN_LEN*8-1'b1:0]wr_data,//write data
input  [7:0]wr_cnt,//write data lenth include device address 
output reg [RMEN_LEN*8-1'b1:0]rd_data = 0,//read data 
input  [7:0]rd_cnt,//read data lenth
input  iic_en,//iic_en == 1 enable iic transmit
input  iic_mode,//iic_mode = 1 random read iic_mode = 0 current read or page read
output reg iic_busy  = 1'b0,//iic controller busy
output reg sda_dg  = 1'b0//for ila debug
);

parameter IDLE    = 4'd0;
parameter START   = 4'd1;
parameter W_WAIT  = 4'd2;
parameter W_ACK   = 4'd3;
parameter R_WAIT  = 4'd4;  
parameter R_ACK  = 4'd5; 
parameter STOP1   = 4'd6;  
parameter STOP2   = 4'd7;   

reg [2:0] IIC_S = 4'd0;
//generate  scl
reg [15:0] clkdiv = 16'd0;   
reg scl_clk = 1'b0;
 
always@(posedge clk_i)
    if(clkdiv < CLK_DIV)    
        clkdiv <= clkdiv + 1'b1;
    else begin
        clkdiv <= 16'd0; 
        scl_clk <= !scl_clk;
    end

parameter OFFSET = CLK_DIV - CLK_DIV/4;        
wire scl_offset  = (clkdiv == OFFSET);//scl delay output to fit timing
     
reg iic_busy = 1'b0;
reg scl_r = 1'b1;
reg sda_o = 1'b0;    
reg [7:0] sda_r = 8'd0;
reg [7:0] sda_i_r = 8'd0;
reg [7:0] wcnt = 8'd0;
reg [7:0] rcnt = 8'd0;
reg [2:0] bcnt = 3'd0;
reg rd_en = 1'b0;

wire sda_i;

assign iic_sda = sda_o ? 1'bz : sda_o;
            
always @(posedge clk_i) iic_scl <=  scl_offset ?  scl_r : iic_scl;       

//scl output
always @(*) begin
    if(IIC_S == IDLE || IIC_S == STOP1 || IIC_S == STOP2)
        scl_r <= 1'b1;
    else 
        scl_r <= ~scl_clk;
end   
//sda output 
always @(*) begin
    if(IIC_S == START || IIC_S == STOP1 || (IIC_S == R_ACK && (rcnt != rd_cnt)))
        sda_o <= 1'b0;
    else if(IIC_S == W_WAIT)
        sda_o <= sda_r[7]; 
    else  sda_o <= 1'b1;
end   
//sda output shift
always @(negedge scl_clk) begin
    if(IIC_S == W_ACK || IIC_S == START)begin
        sda_r <= wr_data[(wcnt*8) +: 8];
        if( rd_en ) sda_r <= {wr_data[7:1],1'b1};
    end
    else if(IIC_S == W_WAIT)
        sda_r <= {sda_r[6:0],1'b1};
    else 
        sda_r <= sda_r;
end
//sda input shift   
always @(posedge scl_clk) begin
    if(IIC_S == R_WAIT ||IIC_S == W_ACK ) begin
        sda_i_r <= {sda_i_r[6:0],sda_i};
    end
    else if(IIC_S == R_ACK)
        rd_data[((rcnt-1'b1)*8) +: 8] <= sda_i_r[7:0];
    else if(IIC_S == IDLE)begin
        sda_i_r <= 8'd0;
    end 
end

reg iic_sda_r = 1'b1;
always @(posedge scl_clk) iic_sda_r <= sda_i;
always @(posedge clk_i) sda_dg <= sda_i;

//iic state machine
always @(negedge scl_clk or negedge rst_n)begin
      if(!rst_n) begin
		iic_busy <= 1'b0;
        wcnt <= 8'd0;
        rcnt <= 8'd0;
        rd_en <= 1'b0;
	end
	else begin
        case(IIC_S) //sda = 1 scl =1
        IDLE://idle wait iic_en == 1'b1 start trasmit   rd_en == 1'b1 restart 
        if(iic_en == 1'b1 || rd_en == 1'b1)begin 
           iic_busy <= 1'b1;        
           IIC_S  <= START;
        end
        else begin
           iic_busy <= 1'b0;
           wcnt <= 8'd0;
           rcnt <= 8'd0;
           rd_en <= 1'b0;
        end
        START:begin //sda = 0  then scl_clk =0 scl =0 generate start
           bcnt <= 3'd7;          
           IIC_S  <= W_WAIT;
        end           
        W_WAIT://write data 
        begin
           if(bcnt > 3'd0)
               bcnt  <= bcnt - 1'b1; 
           else begin
               wcnt <= wcnt + 1'b1; 
               IIC_S  <= W_ACK;
           end
        end 
        W_ACK://write data ack
        begin 
           if(wcnt < wr_cnt)begin 
              bcnt <= 3'd7;
              IIC_S <= W_WAIT;
           end
           else if(rd_cnt > 3'd0)begin// read data
              if(rd_en == 1'b0 && iic_mode == 1'b1)begin 
                  rd_en <= 1'b1;
                  IIC_S <= IDLE;  
              end
              else 
                  IIC_S <= R_WAIT;
              bcnt <= 3'd7;
           end
           else
              IIC_S <= STOP1; 
              if(iic_sda_r == 1'b1)
              IIC_S <= STOP1;
        end  
        R_WAIT://read data
        begin
           rd_en <= 1'b0;
           bcnt  <= bcnt - 1'b1; 
           if(bcnt == 3'd0)begin
              rcnt <= (rcnt < rd_cnt) ? (rcnt + 1'b1) : rcnt;
              IIC_S  <= R_ACK;
           end
        end
        R_ACK://read date ack
        begin
           bcnt <= 3'd7;
           IIC_S <= (rcnt < rd_cnt) ? R_WAIT : STOP1; 
        end  
        STOP1://sda = 0 scl = 1
            IIC_S <= STOP2;
        STOP2://sda = 1 scl = 1
            IIC_S <= IDLE;          
        default:
            IIC_S <= IDLE;
		endcase
	end
end

endmodule
