qianshuyuank/MLKPAI-FMin01/01_start/02_peripheral_demo/06_sdram_test/fdma_sdram_test_prj/uisrc/03_ip/pll/pll_sim.v

// Verilog netlist created by TD v5.0.43066
// Sun Apr 17 21:12:55 2022

`timescale 1ns / 1ps
module pll  // pll.v(26)
  (
  refclk,
  reset,
  clk0_out,
  clk1_out,
  clk2_out,
  clk3_out,
  clk4_out,
  extlock
  );

  input refclk;  // pll.v(35)
  input reset;  // pll.v(36)
  output clk0_out;  // pll.v(38)
  output clk1_out;  // pll.v(39)
  output clk2_out;  // pll.v(40)
  output clk3_out;  // pll.v(41)
  output clk4_out;  // pll.v(42)
  output extlock;  // pll.v(37)

  wire clk0_buf;  // pll.v(44)

  EG_PHY_GCLK bufg_feedback (
    .clki(clk0_buf),
    .clko(clk0_out));  // pll.v(46)
  EG_PHY_CONFIG #(
    .DONE_PERSISTN("ENABLE"),
    .INIT_PERSISTN("ENABLE"),
    .JTAG_PERSISTN("DISABLE"),
    .PROGRAMN_PERSISTN("DISABLE"))
    config_inst ();
  EG_PHY_PLL #(
    .CLKC0_CPHASE(7),
    .CLKC0_DIV(8),
    .CLKC0_DIV2_ENABLE("DISABLE"),
    .CLKC0_ENABLE("ENABLE"),
    .CLKC0_FPHASE(0),
    .CLKC1_CPHASE(1),
    .CLKC1_DIV(8),
    .CLKC1_DIV2_ENABLE("DISABLE"),
    .CLKC1_ENABLE("ENABLE"),
    .CLKC1_FPHASE(0),
    .CLKC2_CPHASE(3),
    .CLKC2_DIV(8),
    .CLKC2_DIV2_ENABLE("DISABLE"),
    .CLKC2_ENABLE("ENABLE"),
    .CLKC2_FPHASE(0),
    .CLKC3_CPHASE(49),
    .CLKC3_DIV(50),
    .CLKC3_DIV2_ENABLE("DISABLE"),
    .CLKC3_ENABLE("ENABLE"),
    .CLKC3_FPHASE(0),
    .CLKC4_CPHASE(23),
    .CLKC4_DIV(24),
    .CLKC4_DIV2_ENABLE("DISABLE"),
    .CLKC4_ENABLE("ENABLE"),
    .CLKC4_FPHASE(0),
    .DERIVE_PLL_CLOCKS("DISABLE"),
    .DPHASE_SOURCE("DISABLE"),
    .DYNCFG("DISABLE"),
    .FBCLK_DIV(6),
    .FEEDBK_MODE("NORMAL"),
    .FEEDBK_PATH("CLKC0_EXT"),
    .FIN("25.000"),
    .FREQ_LOCK_ACCURACY(2),
    .GEN_BASIC_CLOCK("DISABLE"),
    .GMC_GAIN(2),
    .GMC_TEST(14),
    .ICP_CURRENT(9),
    .IF_ESCLKSTSW("DISABLE"),
    .INTFB_WAKE("DISABLE"),
    .KVCO(2),
    .LPF_CAPACITOR(1),
    .LPF_RESISTOR(8),
    .NORESET("DISABLE"),
    .ODIV_MUXC0("DIV"),
    .ODIV_MUXC1("DIV"),
    .ODIV_MUXC2("DIV"),
    .ODIV_MUXC3("DIV"),
    .ODIV_MUXC4("DIV"),
    .PLLC2RST_ENA("DISABLE"),
    .PLLC34RST_ENA("DISABLE"),
    .PLLMRST_ENA("DISABLE"),
    .PLLRST_ENA("ENABLE"),
    .PLL_LOCK_MODE(0),
    .PREDIV_MUXC0("VCO"),
    .PREDIV_MUXC1("VCO"),
    .PREDIV_MUXC2("VCO"),
    .PREDIV_MUXC3("VCO"),
    .PREDIV_MUXC4("VCO"),
    .REFCLK_DIV(1),
    .REFCLK_SEL("INTERNAL"),
    .STDBY_ENABLE("DISABLE"),
    .STDBY_VCO_ENA("DISABLE"),
    .SYNC_ENABLE("DISABLE"),
    .VCO_NORESET("DISABLE"))
    pll_inst (
    .daddr(6'b000000),
    .dclk(1'b0),
    .dcs(1'b0),
    .di(8'b00000000),
    .dwe(1'b0),
    .fbclk(clk0_out),
    .load_reg(1'b0),
    .psclk(1'b0),
    .psclksel(3'b000),
    .psdown(1'b0),
    .psstep(1'b0),
    .refclk(refclk),
    .reset(reset),
    .stdby(1'b0),
    .clkc({clk4_out,clk3_out,clk2_out,clk1_out,clk0_buf}),
    .extlock(extlock));  // pll.v(85)

endmodule 
