qianshuyuank/MLKPAI-FMin01/(commit log)

2026-04-18 首次提交：初始化项目，加入 .gitignore 排除生成文件
    [DVP接口引脚定义表.xlsx, FLASH管脚定义表.xlsx, HDMI引脚定义表.xlsx, JTAG管脚定义表 .xlsx, LED、拨码开关、按键与蜂鸣器引脚定义表.xlsx, MLKPAI-FMin01.dxf, TF卡槽、EEPROM与RTC引脚定义表.xlsx, UART引脚信号定义表.xlsx]
2026-04-26 chore: 更新项目文件编码并完善仿真脚本
    - 添加批量转换文件编码至UTF-8的PowerShell脚本
    - 更新.gitignore以忽略更多仿真生成文件
    - 修复多个仿真脚本（cmd.do）中的语法和路径问题
    - 为run_led仿真添加批处理TCL脚本和AI分析日志
    - 修正部分RTL文件中的参数注释和中文乱码
    - 更新多个项目的Anlogic工程文件路径和版本信息
    - 统一多个IP文件的行尾格式
    [SerializerN_1_lvds.vhd, cam_test.v, display.v, eeprom.v, eeprom_test.v, eg4d_sram_fdma_test.v, image_median_filtering.v]
